BrayanACelisGodoy/ProyectoUcurrentUIS/5.Imagenes/Figura9 _2.JPG

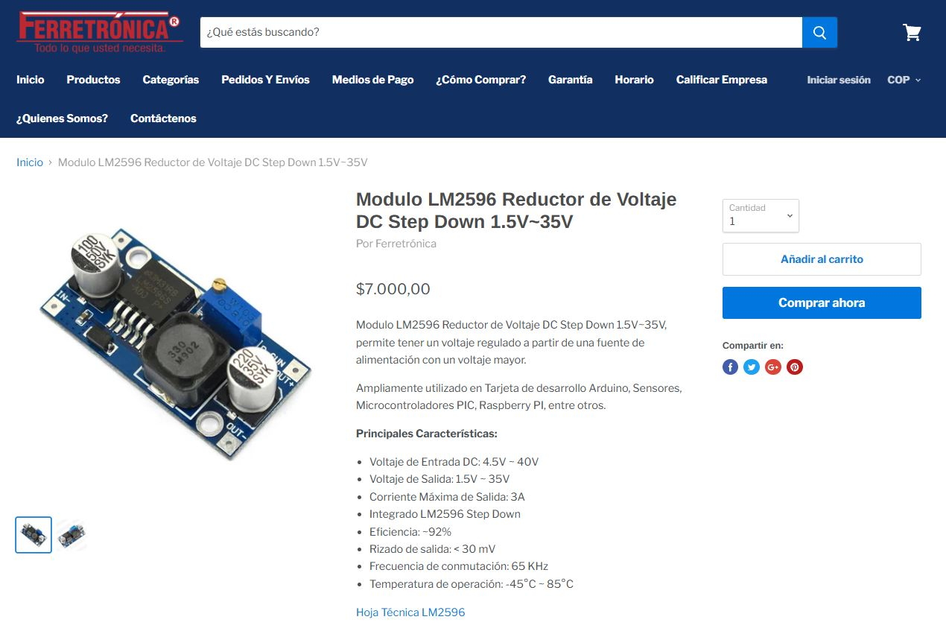
5.Imagenes/Figura9 _2.JPG
