BrayanACelisGodoy/ProyectoUcurrentUIS/5.Imagenes/Figura9 _1.JPG

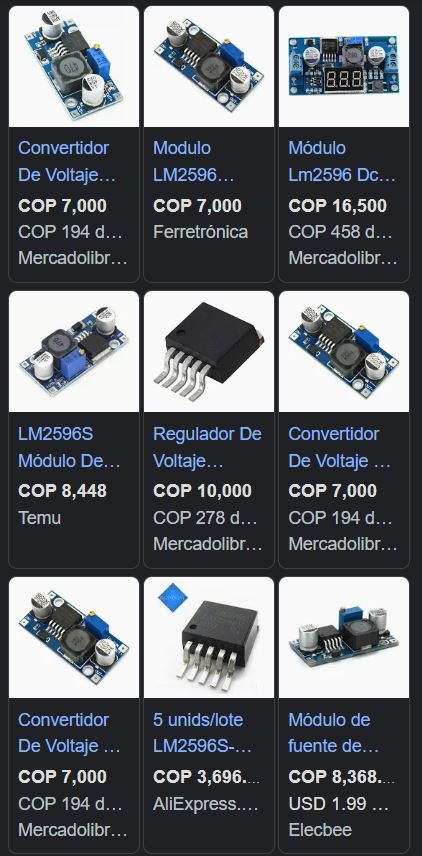
5.Imagenes/Figura9 _1.JPG
