BrayanACelisGodoy/ProyectoUcurrentUIS/4.Informe/Informe_uCurrent.odt

Proyecto Diseño y Mejoras μCurrent

Brayan Andres Celis Godoy, Jeiffer Bernal Tellez

Profesor

Jaime Guillermo Barrero Perez

Universidad Industrial de Santander

Facultad de Fisico-Mecanicas

Escuela de Eléctrica,Electrónica y Telecomunicaciones

Electrónica

Bucaramanga

2024

Tabla de Contenido

Pág.

Lista de Figuras

Pág.

Figura 1: Circuito medición de corriente a voltaje 11

Figura 2: Simulación ideal rango micro amperios 11

Figura 3: Simulación ideal rango mili amperios 11

Figura 4: Circuito comparador umbral mínimo y máximo 13

Figura 5: Circuito de resistencias de medición en rango automático 13

Figura 6: Circuito logica de encendido del mosfet 14

Figura 7: Circuito medición de corriente autónomo 15

Figura 8: Resultados de simulación 16

Lista de Apéndices

pág.

Apéndice A. Programa Esp-32 Visor online 20

(Se indican de dos formas: Si son menos de 27 apéndices, se listan con las letras del alfabeto, si son mayores de 27 apéndices, se listan con números. Al igual que las anteriores listas, también llevan el titulo completo)

Nota: Si los apéndices van dentro del cuerpo o contenido del trabajo de grado listados al final del mismo, se debe indicar el número de la página, si desea agruparlos en una carpeta adjunta no debe colocar número de página, en reemplazo, debe colocar un mensaje que indique:

“Los apéndices están adjuntos”

Glosario

Primer término: la definición inicia en minúscula

Segundo término: la definición inicia en minúscula

Tercer término: la definición inicia en minúscula

# Introducción

La medición de corriente en dispositivos microcontroladores es fundamental para evaluar su consumo y eficiencia, aspectos clave en el desarrollo de aplicaciones de bajo consumo energético. Es necesario contar con métodos efectivos y sencillos para monitorizar el consumo en dispositivos comerciales como el ATmega328P o el ESP32, que presentan múltiples niveles de consumo dependiendo del modo de operación en el que se encuentren. Estos niveles de corriente pueden variar desde mili amperios hasta micro amperios, especialmente en los modos de bajo consumo, como el modo de sueño profundo.

Dada la diversidad en los niveles de consumo de los microcontroladores, es crucial disponer de una herramienta que permita medir estos valores de corriente de manera manual o automática, cambiando entre diferentes rangos según sea necesario. Esto optimiza el monitoreo y asegura que los dispositivos operen de manera eficiente en todos sus estados de funcionamiento, desde el modo activo hasta los modos de ahorro de energía.

Este tipo de medición es particularmente importante en dispositivos que funcionan con baterías, donde el consumo de corriente afecta directamente la duración de la misma. Para maximizar el tiempo de funcionamiento de estos dispositivos, es esencial monitorizar el consumo sin introducir grandes pérdidas en el propio circuito de medición. Los sistemas de medición deben tener voltajes de fuga bajos y un impacto mínimo en el consumo global del dispositivo para que los resultados sean precisos y no comprometan la eficiencia energética general.

Además, en aplicaciones donde la batería es un recurso crítico, como en dispositivos portátiles o sistemas IoT, la capacidad de medir con precisión el consumo en diferentes modos operativos permite a los diseñadores optimizar tanto el hardware como el software, ajustando los ciclos de actividad y sueño profundo para extender la vida útil de la batería. De esta forma, el monitoreo preciso de la corriente no solo asegura un diseño eficiente, sino que también contribuye al desarrollo de dispositivos más duraderos y sostenibles.

# 1.Marco teórico

Los títulos de primer nivel se presentan centrados, con negrita. El párrafo inicia a dos espacios del titulo con una sangría de 1,27 cm al inicio del mismo. Estos títulos de primer nivel no necesariamente inician en hoja nueva, pueden iniciar por ejemplo a mitad de página o casi finalizando la hoja dejando dos espacios del párrafo anterior.

La separación entre párrafos es de una interlinea. Recordar que objetivos si se deben presentar en una hoja nueva.

# 2. Objetivos

## 2.1 Objetivo General

Desarrollar un sistema de medición de corriente para microcontroladores, que permita monitorizar el consumo de corriente en diferentes modos operativos, garantizando su precisión y eficiencia en el cambio automático entre rangos de corriente.

## 2.2 Objetivos Específicos

### 2.2.1 Desarrollo del sistema de medición mediante simulación

Diseñar y simular un sistema de medición de corriente que permita verificar el comportamiento del circuito de manera virtual antes de su implementación física.

### 2.2.2 Desarrollo del diseño del PCB

Desarrollar el esquema y diseño del PCB del sistema de medición de corriente, teniendo en cuenta los componentes seleccionados para garantizar un tamaño compacto, bajo consumo energético y bajo costo.

### 2.2.3 Desarrollo del sistema de visualización de lecturas

Desarrollar un aplicativo que permita la conexión y visualización inalámbrica de las lecturas de corriente del sistema, proporcionando una interfaz de usuario sencilla para el monitoreo en tiempo real.

# 3.Metodología

El diseño del circuito debe cumplir con características específicas que garanticen su correcto funcionamiento en microcontroladores. El sistema será operado por batería, lo que requiere un bajo consumo energético para maximizar la duración de la misma. El circuito estará orientado a la medición de corriente continua, y los rangos de medición serán de 500 mili amperios y 500 micro amperios.

La transición entre estos rangos deberá ser manual o automática, dependiendo de las necesidades operativas. Para garantizar una interferencia mínima en el sistema, el circuito deberá tener un voltaje de fuga de 5 mV/500 mA y 5 mV/500 µA, con una salida máxima de 500 mV en cualquier rango.

Finalmente, los datos de la medición deberán transmitirse inalámbrica mente a un dispositivo externo, como un celular o una computadora, para permitir el monitoreo remoto en tiempo real.

Todo esto se realizará mediante un desglose progresivo, partiendo de un modelo ideal del circuito hasta llegar a un desarrollo completo y detallado del sistema. Para validar el comportamiento del circuito, se realizarán simulaciones utilizando LTspice, lo que permitirá verificar el diseño antes de proceder a una posible implementación física.

## 3.1 Solución Ideal

El circuito de medición de corriente a voltaje es ampliamente utilizado en la industria y su construcción se basa en un amplificador operacional (opamp) configurado en retroalimentación negativa. En este tipo de configuración, el opamp actúa como un amplificador de transimpedancia, convirtiendo la corriente de entrada en un voltaje proporcional, lo que facilita la medición precisa de corrientes.

Para lograr una medición efectiva de corriente en microcontroladores, debemos tener en cuenta las resistencias de medición asociadas a los voltajes de fuga característicos del sistema. Los valores de estas resistencias se pueden calcular utilizando la relación entre el voltaje de fuga y la corriente máxima medida. De esta manera, obtenemos:

- {R} rsub {mA} = {5 mV} over {500 mA} = 10 left [m Ω right ]
- {R} rsub {μ A} = {5 mV} over {500 mA} = 10 left [Ω right ]

Con estos valores de resistencias, cumplimos las características de los voltajes de fuga exigidos por el sistema, asegurando una medición precisa sin introducir una carga significativa en el circuito.

Como se puede observar en la Figura 1, el circuito utiliza dos amplificadores operacionales conectados en cascada para mejorar el filtrado de la señal y optimizar la adquisición de datos. Los valores de amplificación de estos opamps se han ajustado para asegurar que el sistema sea capaz de aprovechar el rango completo de saturación Figura 1: Circuito medición de corriente a voltaje del amplificador, permitiendo una medición adecuada en los dos modos de operación (miliamperios y microamperios).

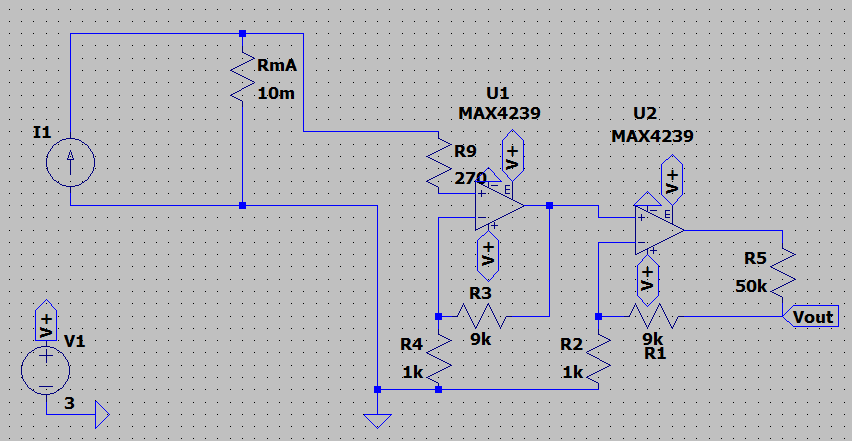
[picture p27: figure]
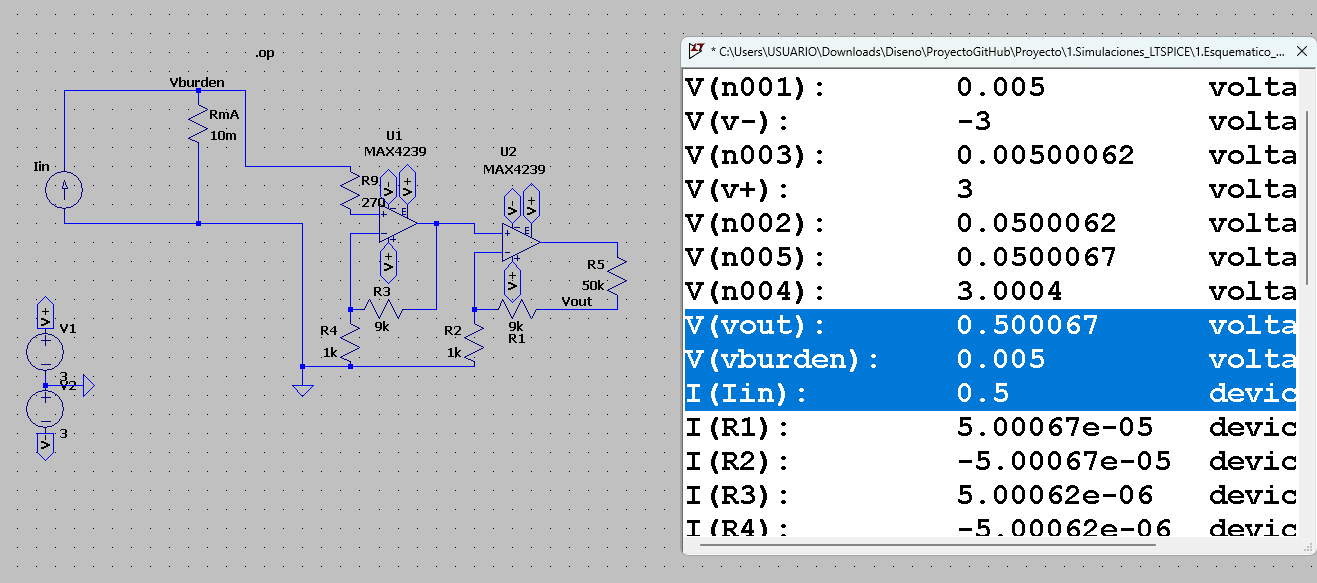
[picture p28: figure]

Medición mA

Figura 2: Circuito de medición en corriente de mA y µA

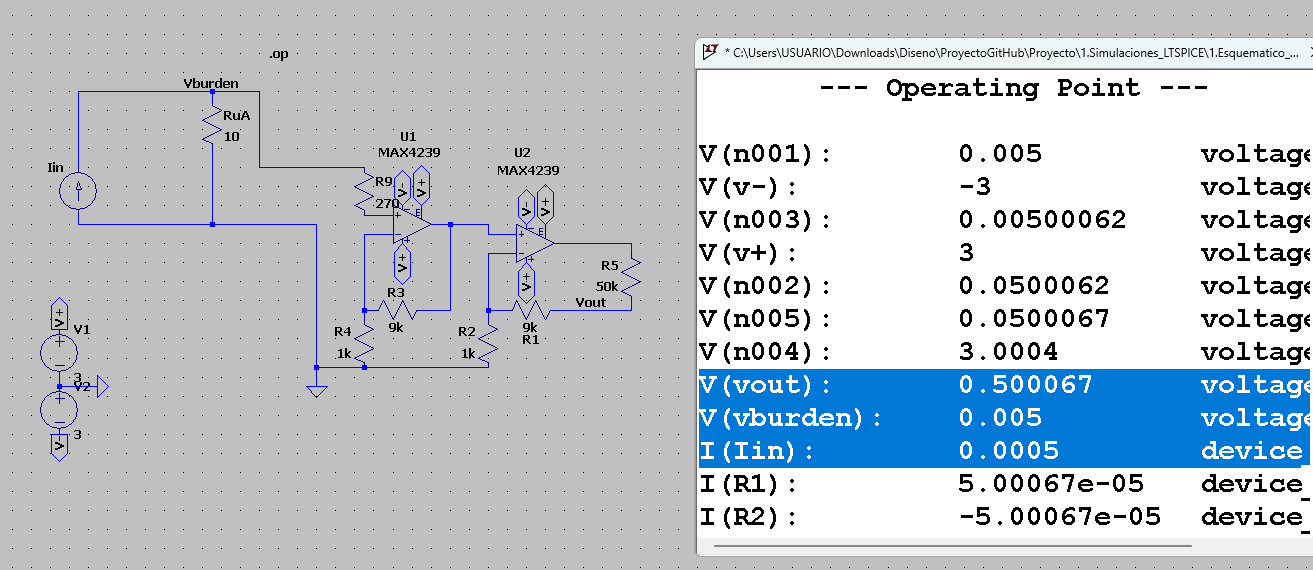
[picture p29: figure]

Medición µA

Como podemos observar en las Figura 2 la simulación ideal nos muestra que, con una corriente de 500 µA y 500 mA, se obtiene una salida de 500 mV, lo cual era el objetivo de diseño. Este resultado se alcanzó mediante la implementación de una amplificación con ganancia de 100 en el circuito, lo que permitió escalar las señales de corriente a niveles adecuados para su procesamiento.

Además, para ajustar el voltaje de salida dentro del rango deseado, se aplicó una división de voltaje. Este ajuste se logró mediante la colocación de una resistencia en serie a la salida del opamp, con un factor de división de 6, lo que permitió reducir el voltaje de salida al valor final de 500 mV en el punto de medición (Vout). De esta manera, conseguimos que el sistema entregue los 500 mV requeridos, tanto en el rango de 500 µA como en el de 500 mA, cumpliendo con las especificaciones del proyecto.

## 3.2 Solución por bloques

A partir de la solución ideal para la medición de corriente y su correspondiente rango de salida, se procede a desglosar el desarrollo de las demás características solicitadas, así como las mejoras que se desean implementar en el sistema. Estas mejoras se estructuran en bloques funcionales, cada uno de los cuales cumple una función específica dentro del sistema global.

### 3.2.1 Selector de Modo Automático

Para el modo de rango automático, se necesita un monitoreo constante de la salida. Cuando se supera un umbral de voltaje máximo, se debe cambiar del rango de µA a mA, y en el caso de caer por debajo del umbral de voltaje mínimo, se debe cambiar de mA a µA. Esto se puede lograr mediante el uso de amplificadores operacionales (opamps) configurados como comparadores de señal, encargados de detectar los límites y realizar el cambio de rango de manera automática.

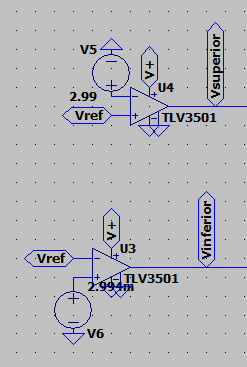
[picture p30: figure]

Figura 3: Circuito comparador umbral mínimo y máximo

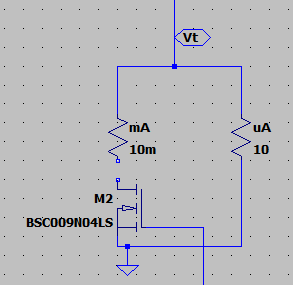
[picture p31: figure]

Figura 4: Circuito de resistencias de medición en rango automáticoComo se muestra en la Figura 3 el montaje de estos dos comparadores está diseñado para detectar los límites de cambio de rango. Cuando los comparadores detectan que se ha alcanzado el umbral predefinido, un MOSFET utilizado como switch actúa para cambiar el rango de medición. Este MOSFET permite una transición suave y eficiente entre los rangos de microamperios y miliamperios, ajustando la configuración del circuito en función de la corriente que se está midiendo.

En la Figura 4, se puede observar que el MOSFET se coloca en serie con la resistencia de 10 mΩ. Esto permite que el rango de medición de micro amperios permanezca activo utilizando la resistencia de 10 Ω, mientras que, al alcanzar el valor máximo de salida en este rango, el MOSFET se activa, realizando el cambio de rango automáticamente.

Físicamente, la corriente siempre tomará el camino de menor resistencia, por lo que, una vez que el MOSFET se encienda, la corriente pasará por la resistencia de 10 mΩ, permitiendo medir correctamente en el rango de mili amperios. Esto introduce una característica adicional importante en el circuito: la resistencia de encendido del MOSFET no debe ser muy alta, ya que podría alterar el valor de la medición en el rango de mA. Si la resistencia es demasiado elevada, afectaría la precisión de las mediciones al introducir una caída de tensión no deseada.

Dado que ya contamos con una señal lógica generada al superar los umbrales de voltaje definidos por los comparadores, es posible implementar un sistema lógico que controle el encendido del MOSFET de manera precisa. Este sistema lógico permitirá automatizar el cambio de rango entre microamperios y miliamperios, asegurando la independencia total del proceso de medición.

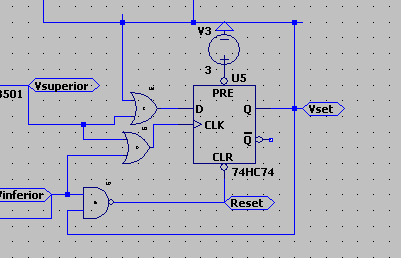
[picture p32: figure]

Figura 5: Circuito de lógica selección automática

En el circuito mostrado en la Figura 5, obtenemos la lógica de encendido utilizando un latch Set/Reset (SR). En la entrada D (Set), se encuentra una compuerta OR que recibe tanto la señal del umbral superior como la salida del propio latch. Esta configuración asegura que, una vez que la corriente supera el umbral superior, el latch se mantenga en el estado activado hasta que sea necesario cambiar de nuevo. La compuerta OR permite que la señal del umbral superior o el estado del latch puedan establecer el sistema, evitando que el cambio de estado ocurra accidentalmente debido a la medición.

Para gestionar los cambios entre rangos, utilizamos la entrada CLK del latch, que responde a flancos ascendentes. Las señales de los umbrales superior e inferior se combinan mediante otra compuerta OR, lo que genera el pulso de reloj necesario para realizar el cambio de rango. Así, el sistema puede cambiar automáticamente entre los rangos de micro amperios y mili amperios según el valor de la corriente medida.

El pin CLR (Reset), que tiene una lógica negada (se activa con un nivel bajo), está controlado por una compuerta NAND. Esta lógica garantiza que el sistema regrese al rango de µA cuando la corriente cae por debajo del umbral inferior y estaba previamente en el rango de mA. Esta combinación asegura que el sistema vuelva al modo de baja corriente solo cuando sea necesario, evitando cambios inesperados en el estado del latch.

En la Figura 6 se presenta el circuito completo de medición junto con el selector de rangos autónomos. Este circuito permite el cambio automático entre los rangos de mili amperios y micro amperios, de acuerdo con los umbrales predefinidos. Para observar el comportamiento del circuito en simulación, se utilizan dos fuentes de corriente: una que recorre los valores correspondientes al rango de mA y otra para los valores de µA Figura 6: Circuito medición de corriente autónomo.

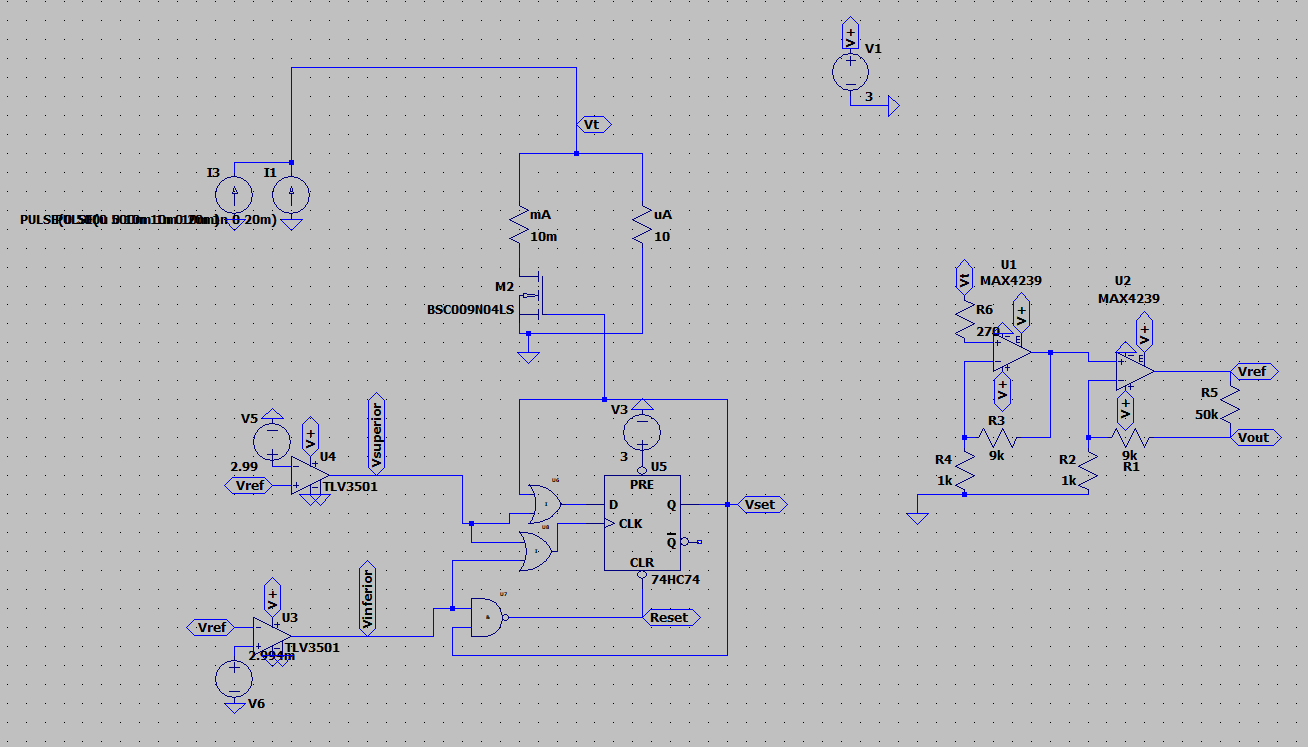
[picture p33: figure]

Al simular el circuito con estas dos fuentes, es posible visualizar las respuestas del sistema tanto en la señal de salida como en las corrientes que atraviesan las resistencias de medición. De esta manera, podemos verificar que el sistema cambia correctamente entre los rangos de medición de 10 mΩ para los mili amperios y 10 Ω para los micro amperios, dependiendo de los valores de corriente aplicados. Esto asegura que el selector de rangos autónomos funcione de manera eficiente y precisa en el control de la medición.

Como se puede observar en los resultados de simulación (Figura 7), los gráficos inferiores muestran el comportamiento del circuito cuando las dos fuentes de corriente alimentan el sistema. Las segunda y tercera gráficas representan las corrientes que atraviesan las resistencias de medición. En el momento en que la corriente alcanza valores de mili amperios, la resistencia asociada a este rango se activa automáticamente, aunque se puede notar una pequeña fuga a través de la resistencia del rango de micro amperios Figura 7: Resultados de simulación.

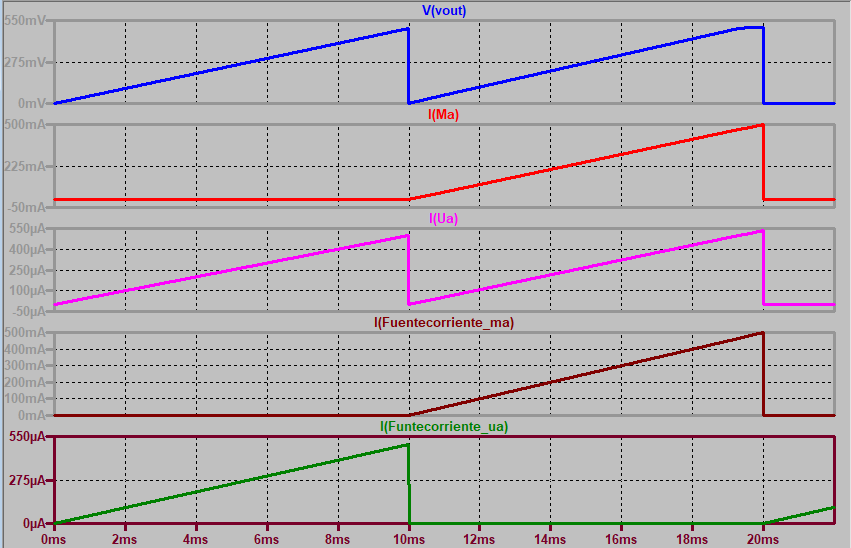
[picture p34: figure]

Finalmente, en la primera gráfica se muestra el voltaje de salida, que se mantiene en un rango cercano a 500 mV en ambos casos. Sin embargo, se observa que, debido a la resistencia asociada al MOSFET, el valor de salida en el rango de mili amperios se ve afectado, mostrando una pequeña desviación con respecto al valor ideal.

### 3.2.2 Módulo de Carga de Batería

Para maximizar el aprovechamiento de los recursos y garantizar un uso eficiente del circuito, se ha decidido utilizar una batería Li-Ion. La elección de este tipo de batería se debe a su alta densidad de energía y su capacidad de recarga, lo que evita el desperdicio de recursos al no tener que reemplazarla constantemente.

Para implementar el sistema de carga de la batería, existen dos enfoques posibles:

1. Compra de un módulo de carga completo: Este enfoque implica adquirir un módulo ya diseñado que cumpla con las características necesarias, como el tiempo de carga adecuado y los sistemas de seguridad integrados (protección contra sobrecarga, descarga profunda, etc.). Estos módulos suelen incluir un puerto de carga USB, lo que facilita su uso e integración.
2. Diseño propio del circuito de carga: Otra opción es diseñar y construir el sistema de carga utilizando componentes individuales, como el controlador de carga TP4056, que permite ajustar el proceso de carga de la batería según nuestras necesidades específicas. Aunque este enfoque ofrece mayor flexibilidad en el diseño, puede ser más laborioso y costoso en términos de tiempo.

En términos de selección, la opción más apropiada en muchos casos es comprar un módulo preensamblado, ya que suele ser más económico y ofrece la ventaja de estar completamente integrado, con todas las protecciones necesarias y un puerto de carga USB ya incluido.

(agregar imagenes del modulo y referencia del mismo y hablar de precio)

### 3.2.3 Módulo Conversor DC-DC

Otro elemento adicional que se podría incorporar al diseño es un conversor DC-DC, con el objetivo de alimentar el ESP32 y su módulo Wi-Fi, lo que permitiría el envío de datos de manera inalámbrica. Este conversor también serviría para mantener un valor de alimentación fijo de 3V para el circuito, dado que fue bajo este voltaje que se realizó la calibración de todo el sistema.

Al igual que el módulo de carga, el conversor DC-DC puede ser adquirido como un módulo pre ensamblado, que ya cumpla con las características necesarias para ofrecer estabilidad en la salida. Alternativamente, se podría diseñar e implementar utilizando componentes discretos, como el LM2596, que permitiría ajustar el voltaje de salida y garantizar la estabilidad del sistema.

La elección entre comprar un módulo pre ensamblado o realizar el diseño propio dependerá de factores como el costo y el tiempo. En muchos casos, adquirir un módulo pre ensamblado es la opción más práctica, ya que asegura la estabilidad del voltaje y minimiza el riesgo de comprometer la calibración del sistema o la integridad del microcontrolador que se utiliza para el envío de datos.

# 4. Desarrollo del PCB

## 4.1 Esquemáticos PCB

# 5. Desarrollo de aplicación

Dadas las especificaciones requeridas para el circuito, donde la única función obligatoria del ESP32 es enviar los datos a una interfaz gráfica para su visualización en un computador o dispositivo móvil, al utilizar herramientas como el ESP32 para la lectura de estos datos análogos tenemos que tener en cuenta la incertidumbre que se genera al tener una conexión de esta señal análoga y ser convertida a bits mas exactamente los 12 bits de la esp32 podemos calcular la incertidumbre siendo que conocemos el rango máximo de salida que es de 500 mV.

incertidumbre=frac{ 2^{bits} }{ rango Max }=frac{ 2^12 }{ 500mV }=0,122mV

Con este resultado podemos obtener que en la visualización que realicemos sin importar como se haga tendremos este valor de ± 0,122mV en la medición,con lo cual ya nos quedar desarrollar como queremos que sea la lectura de los dato,existen dos posibles enfoques para el desarrollo de la aplicación:

1. Servidor web con el ESP32: Se decidió optar por esta opción debido a la autonomía del circuito, ya que el ESP32 solo funcionará como un mediador entre el circuito de medición y el dispositivo de visualización. En este caso, se desarrollará un servidor web utilizando el ESP32, permitiendo que cualquier dispositivo conectado a su red visualice los datos a través de un navegador. La página web se desarrollará en HTML, lo que permitirá que los datos sean accesibles desde cualquier dispositivo con un navegador, siempre y cuando esté conectado a la red generada por el ESP32. Esta opción es práctica y versátil, permitiendo el acceso sin necesidad de instalar software adicional.
2. Aplicativo dedicado (aparte): Aunque se ha optado por el servidor web, se incluirá un apartado que explorará la posibilidad de desarrollar un aplicativo dedicado. Este enfoque podría cambiar el procesamiento de la señal, controlando completamente el sistema a través del microcontrolador ESP32. Un aplicativo dedicado podría ser desarrollado tanto para computador como para celular, ofreciendo mayor control sobre el sistema y permitiendo optimizar la experiencia de usuario. Sin embargo, tendría la desventaja de requerir versiones diferentes para cada tipo de dispositivo y la necesidad de que los usuarios instalen la aplicación.

Cada enfoque tiene sus ventajas y desventajas. El servidor web es más versátil y fácil de implementar, mientras que un aplicativo dedicado ofrecería mayor control y personalización, con la posibilidad de cambiar la forma en que se procesa y controla la señal directamente desde el ESP32.

## 5.1 Aplicativo mediante servidor web

Dado que el diseño del circuito es completamente autónomo en el procesamiento de la señal, y la ESP32 solo se utilizará para enviar la información a un celular o computador, el desarrollo del aplicativo de visualización se enfocará únicamente en mostrar el valor medido. Con el circuito del latch manejando la lógica de cambio de rangos, la ESP32 solo necesitará implementar un sistema que permita visualizar los datos a través de un navegador web.

El desarrollo del aplicativo en el servidor web incluirá:

- Un puerto de entrada de la ESP32 para la visualización del valor medido (corriente).
- Un puerto de detección que indicará si el sistema está operando en el rango de miliamperios (mA) o microamperios (µA).
- Un puerto para el modo automático, que indicará si el sistema está realizando los cambios de rango automáticamente.

Otra manera posible de realizar la visualización de los datos es conectando la ESP32 a una red Wi-Fi existente. Conociendo su dirección IP, los usuarios podrán acceder a la interfaz web y visualizar los datos desde cualquier dispositivo en la misma red. Esta opción permite una mayor flexibilidad en la conexión y acceso remoto a los datos sin depender de una red generada exclusivamente por el ESP32.

Este diseño web permitirá a los usuarios visualizar en tiempo real el estado y las mediciones del sistema a través de cualquier dispositivo conectado a la red del ESP32, ya sea mediante su propia red o una red Wi-Fi existente.

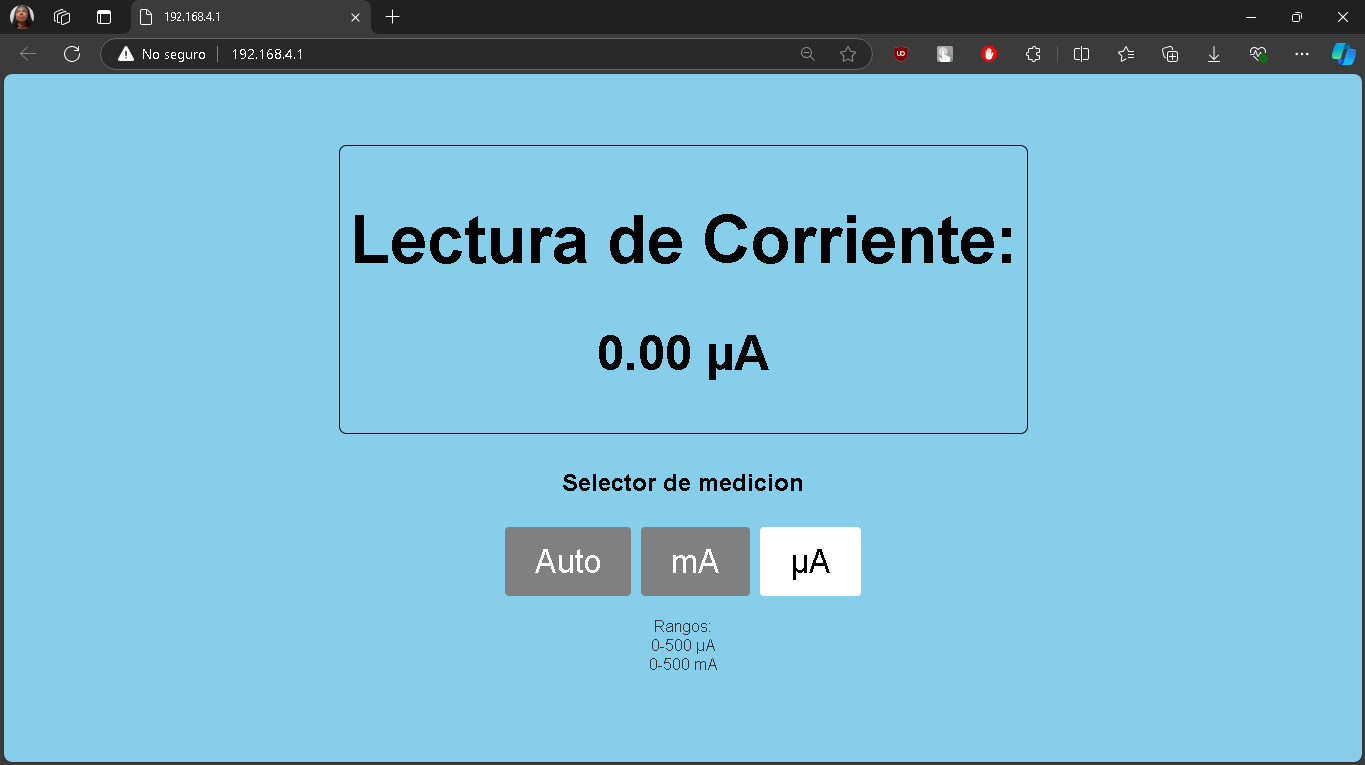
[picture p35: figure]
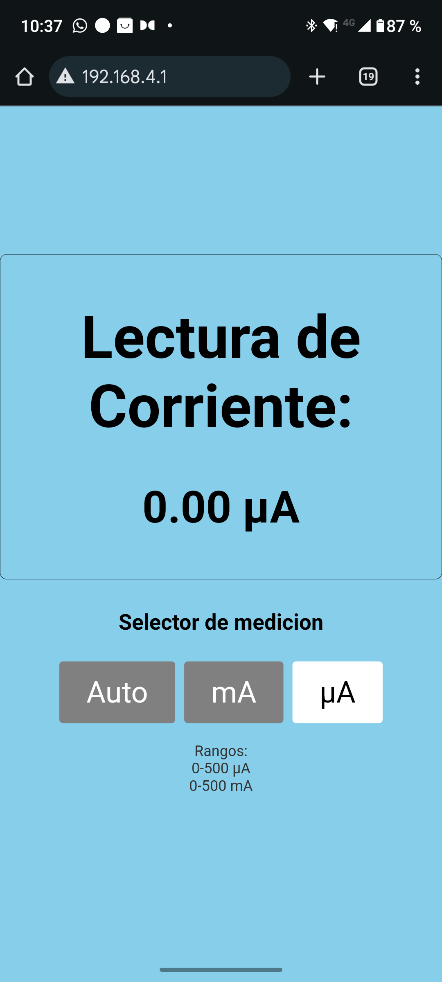
[picture p36: figure]

Visualizado en PC Visualizado en Celular

Figura 8: Esquema visualización por HTML

En la Figura 8 se puede ver el desarrollo de la página web, tanto en un PC como en un celular, mostrando la interfaz diseñada para la visualización de los datos. En el apéndice A se incluye el código fuente utilizado para el desarrollo del servidor web, acompañado de una explicación detallada de su funcionamiento. En este caso, se ha configurado el ESP32 para que genere una red Wi-Fi propia, a la cual se conecten los dispositivos que visualizarán los datos.

## 5.2 Aplicativo dedicado

Dado un enfoque con un aplicativo dedicado la mejor opcion seria eliminar la parte logica del circuito con lo cual en ves de depender de la lógica del latch para los cambios de rango se haria un procesamiento de la señal en el esp32 el cual se encargaría de controlar el mosfet.

El desarrollo de un aplicativo dedicado incluira:

- Un puerto de entrada de la ESP32 para la visualización del valor medido (corriente).
- Un puerto de activación que sera el encargado de controlar el encendido del mosfet en los diferentes rangos.
  El uso de aplicación dedicada nos permite eliminar el procesado por HTML en el propio esp32 lo cual puede significar una mejora de eficiencia ya que se puede colocar en el modo de sueño ligero todo el tiempo y despertarse para procesar y enviar los datos solo cuando detecte cambio.

# 6. Conclusiones

(Va en capitulo separado de las conclusiones, pero no necesariamente en hoja nueva y en este apartado se expresa las perspectivas del autor a fin de complementar con nuevas ideas a la investigación original)

# Referencias Bibliográficas

(No lleva número de capitulo e inicia en hoja nueva)

Ejemplo

Congreso de la República de Colombia (1979). Ley 11 del 5 de marzo de 1979 “Por la cual se reconoce la profesión de bibliotecólogo y se reglamenta su ejercicio”. Bogotá: El Congreso

Todas las referencias de las citas del trabajo de grado deben aparecer en esta lista, al igual que las fuentes consultadas. Deben ir en orden alfabético y la primera línea de cada referencia debe ir contra el margen izquierdo, si tiene una segunda o más líneas, lleva sangría después de la primera línea [sangría francesa].

# Apéndices

(No lleva número de capitulo e inicia en hoja nueva)

## Apéndice A. Programa Esp-32 Visor online

#include <WiFi.h>

#include <WebServer.h>

const char* ssid = "ESP32_AP";

const char* password = "123456789";

// Crear una instancia del servidor web

WebServer server(80);

// Definir los pines de entrada

const int pinAutoInput = 19; // Pin para la entrada Auto (GPIO19)

const int pinRangeInput = 5; // Pin para la entrada de rango (uA/mA) (GPIO5)

const int inputPin = 34; // Pin 34 como entrada de señal analógica

// Función para leer la corriente sin conversión

float readCurrent() {

int sensorValue = analogRead(inputPin);

float voltage = (sensorValue / 4095.0) * 3300.0; // Convertir a milivoltios (0-3300mV)

return voltage;

}

// Función para la página principal

void handleRoot() {

// Leer los estados lógicos de las entradas

bool isAuto = digitalRead(pinAutoInput);

bool isMilliAmp = digitalRead(pinRangeInput); // HIGH = mA, LOW = uA

// Definir la unidad de medida dependiendo del estado del pin de rango

String displayUnit = "";

if (isAuto) {

displayUnit = "Auto";

} else if (isMilliAmp) {

displayUnit = "mA";

} else {

displayUnit = "µA";

}

float currentValue = readCurrent(); // Leer la corriente

// Crear el contenido HTML

String html = "<html><head>";

html += "<meta charset='UTF-8'>"; // Añadir la codificación UTF-8

html += "<style>";

html += "html, body { height: 100%; margin: 0; font-family: Arial; font-size: 1.6em; background-color: #87CEEB; }"; // Fondo celeste

html += "body { display: flex; justify-content: center; align-items: center; }";

html += ".container { text-align: center; }";

html += ".box { border: 1px solid black; display: inline-block; padding: 20px; margin-bottom: 20px; border-radius: 15px; font-size: 1.6em; }";

html += ".button { padding: 30px 60px; font-size: 1.6em; margin: 10px; background-color: grey; color: white; border: none; cursor: pointer; border-radius: 8px; }";

html += ".button.selected { background-color: white; color: black; }"; // Botón seleccionado en blanco

html += ".small-text { font-size: 0.8em; color: #333; }";

html += "</style>";

// Añadir JavaScript para auto-actualización

html += "<script>";

html += "setInterval(function() { window.location.reload(); }, 1000);"; // Refrescar cada 1 segundo

html += "</script>";

html += "</head><body>";

html += "<div class='container'>";

html += "<div class='box'><h1>Lectura de Corriente:</h1>";

html += "<h2>" + String(currentValue, 2) + " " + displayUnit + "</h2></div>";

html += "<h3>Selector de medicion</h3>";

// Botones con estado visual según las entradas

html += "<input class='button " + String((isAuto) ? "selected" : "") + "' type='button' value='Auto'>";

html += "<input class='button " + String((!isAuto && isMilliAmp) ? "selected" : "") + "' type='button' value='mA'>";

html += "<input class='button " + String((!isAuto && !isMilliAmp) ? "selected" : "") + "' type='button' value='µA'>";

html += "<p class='small-text'>Rangos:<br>0-500 µA<br>0-500 mA</p>";

html += "</div>";

html += "</body></html>";

server.send(200, "text/html", html);

}

void setup() {

Serial.begin(115200);

pinMode(inputPin, INPUT);

pinMode(pinAutoInput, INPUT);

pinMode(pinRangeInput, INPUT);

WiFi.softAP(ssid, password);

Serial.println("Punto de acceso iniciado");

Serial.print("IP del ESP32: ");

Serial.println(WiFi.softAPIP());

server.on("/", handleRoot);

server.begin();

}

void loop() {

server.handleClient();

if (WiFi.status() == WL_CONNECTED) {

esp_sleep_enable_timer_wakeup(5000000); // Configurar para despertar cada 5 segundos

esp_light_sleep_start(); // Entrar en light sleep

}

}

## Apéndice B.Programa ESP-32 aplicación dedicada.

#include <WiFi.h>

#include <WebServer.h>

const char* ssid = "ESP32_AP";

const char* password = "123456789";

// Crear una instancia del servidor web

WebServer server(80);

// Definir el pin de salida para el MOSFET

const int mosfetPin = 18; // Pin para controlar el MOSFET (GPIO18)

// Variables para guardar el estado del sistema

String mode = "uA"; // Modo actual (uA, mA, Auto)

float currentValue = 0.0; // Valor de corriente leído

String range = "µA"; // Escala de medición actual (uA o mA)

// Función para leer la corriente sin conversión

float readCurrent() {

int sensorValue = analogRead(34); // Pin 34 como entrada de señal analógica

float voltage = (sensorValue / 4095.0) * 500.0; // Convertir a milivoltios (0-3300mV)

return voltage;

}

// Función para procesar el modo automático

void handleAutoMode(float currentValue) {

if (currentValue >= 495) {

// Activar el MOSFET cuando la corriente supere los 495mV

digitalWrite(mosfetPin, HIGH);

range = "mA"; // Cambiar la escala a miliamperios cuando el MOSFET esté encendido

} else if (currentValue < 1) {

// Apagar el MOSFET cuando la corriente sea inferior a 1mV

digitalWrite(mosfetPin, LOW);

range = "µA"; // Cambiar la escala a microamperios cuando el MOSFET esté apagado

}

}

// Función para manejar el cambio de modo desde la aplicación

void handleSetMode() {

if (server.hasArg("mode")) {

mode = server.arg("mode");

// Lógica para los modos

if (mode == "mA") {

digitalWrite(mosfetPin, HIGH); // Encender MOSFET en mA

range = "mA"; // Fijar el rango en miliamperios

} else if (mode == "uA") {

digitalWrite(mosfetPin, LOW); // Apagar MOSFET en uA

range = "µA"; // Fijar el rango en microamperios

}

// No encendemos/apagamos directamente en modo Auto, lo hace handleAutoMode()

}

// Responder a la aplicación confirmando el cambio de modo

server.send(200, "text/plain", "Mode changed to " + mode);

}

// Función para devolver los datos actuales en formato JSON

void handleData() {

currentValue = readCurrent(); // Leer la corriente

// Si el modo es "Auto", procesar automáticamente y cambiar la escala

if (mode == "Auto") {

handleAutoMode(currentValue);

}

// Crear el JSON con las variables que queremos enviar

String jsonData = "{";

jsonData += "\"current\": " + String(currentValue, 2) + ","; // Agregar lectura de corriente

jsonData += "\"mode\": \"" + mode + "\","; // Enviar el modo actual

jsonData += "\"range\": \"" + range + "\""; // Enviar la escala actual (mA o µA)

jsonData += "}";

// Enviar los datos en formato JSON

server.send(200, "application/json", jsonData);

void enterLightSleep() {

Serial.println("Entrando en Light Sleep...");

// Configurar el tiempo de sueño (por ejemplo, 10 segundos)

esp_sleep_enable_timer_wakeup(10 * 1000000); // 10 segundos en microsegundos

Serial.flush(); // Limpiar el buffer serial

esp_light_sleep_start(); // Entrar en light sleep

wakeup_count++; // Contador de veces que ha despertado

Serial.println("Despertado del Light Sleep");

}

enterLightSleep();

}

void setup() {

Serial.begin(115200);

// Configurar los pines

pinMode(34, INPUT); // Pin 34 para la señal de corriente

pinMode(mosfetPin, OUTPUT); // Pin para el MOSFET

// Configurar el WiFi

WiFi.softAP(ssid, password);

Serial.println("Punto de acceso iniciado");

Serial.print("IP del ESP32: ");

Serial.println(WiFi.softAPIP());

// Configurar las rutas del servidor

server.on("/setMode", handleSetMode); // Endpoint para cambiar el modo

server.on("/data", handleData); // Endpoint para obtener los datos actuales

server.begin(); // Iniciar el servidor

}

void loop() {

server.handleClient(); // Manejar las solicitudes del cliente

}

(Los apéndices se indican de dos formas: Si son menos de 27 apéndices, se listan con las letras del alfabeto, si son mayor o igual a 27 apéndices, se listan con números arábigos. Al igual que las anteriores listas, también llevan el título completo)

Nota: Si los apéndices van dentro del cuerpo o contenido del trabajo de grado listados al final del mismo, se debe indicar el número de la página, si desea agruparlos en una carpeta adjunta no debe colocar número de página, en reemplazo, debe colocar un mensaje que indique:

“Los apéndices están adjuntos y puede visualizarlos en la base de datos de la biblioteca UIS”

Tener en cuenta que, en el uso de Normas APA no pueden ir contenidos en mayúscula (Incluyendo títulos), Sólo en mayúsculas las siglas y la cornisa.

Las recomendaciones y sugerencias para la elaboración de esta plantilla fueron obtenidas y adaptadas teniendo en cuenta la Guía resumen del Manual de Publicaciones con Normas APA

Séptima edición 2020 | www.normasapa.pro Traducción basada en: https://apastyle.apa.org/style-grammar-guidelines/index y en American Psychological Association (2020)

UNIVERSIDAD INDUSTRIAL DE SANTANDER 29
