BrayanACelisGodoy/ProyectoUcurrentUIS/5.Imagenes/Figura1.png

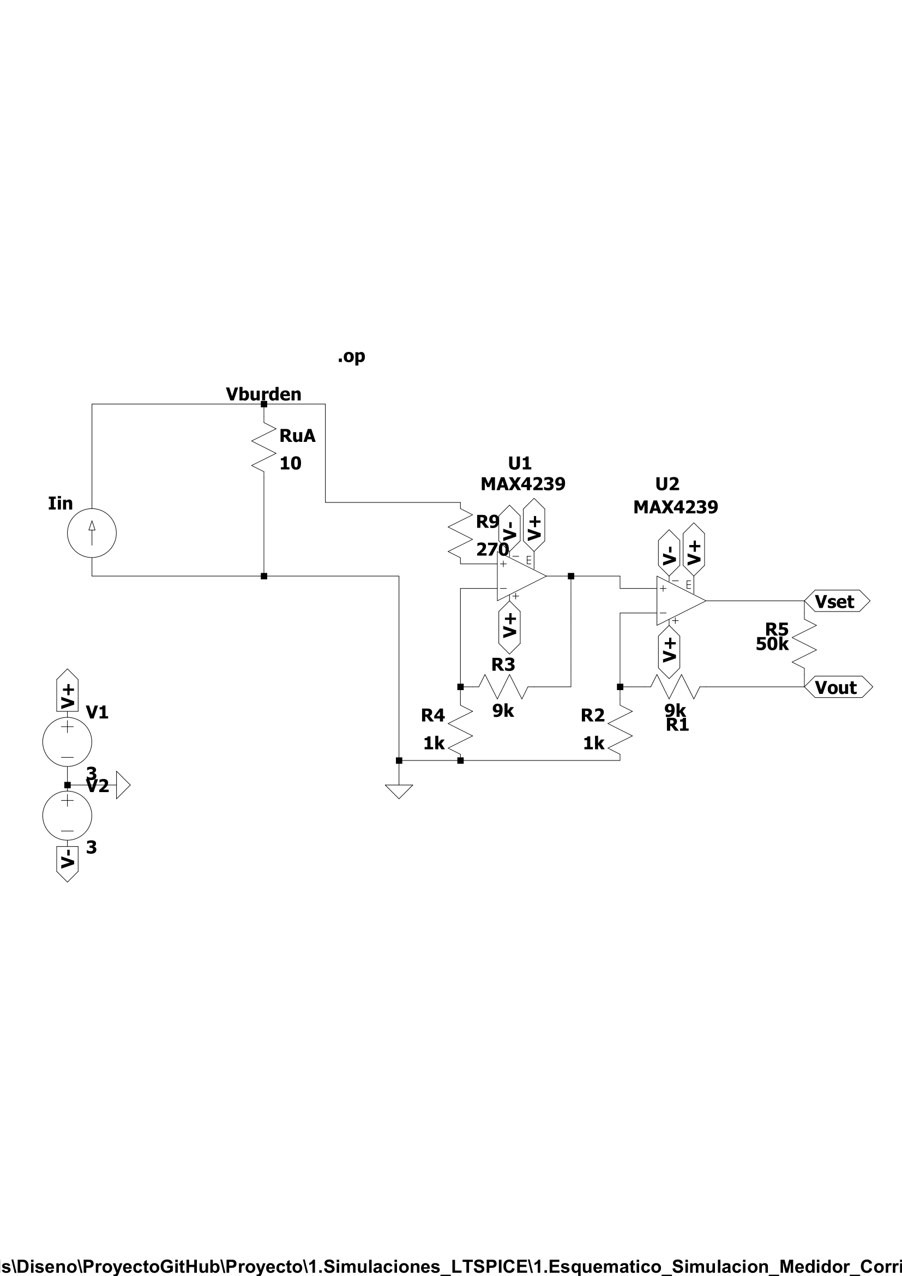
5.Imagenes/Figura1.png
