BrayanACelisGodoy/ProyectoUcurrentUIS/5.Imagenes/Figura2_1.png

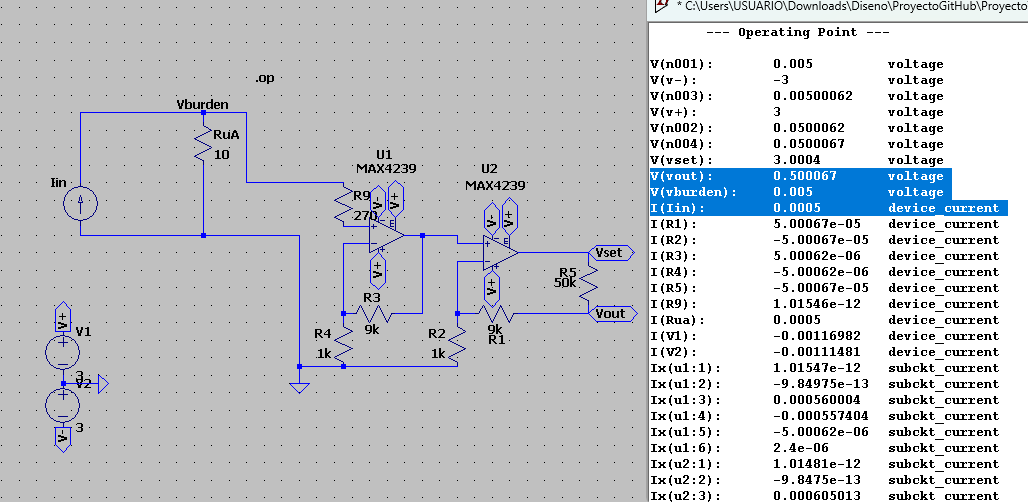
5.Imagenes/Figura2_1.png
