BrayanACelisGodoy/ProyectoUcurrentUIS/5.Imagenes/Figura2_2.png

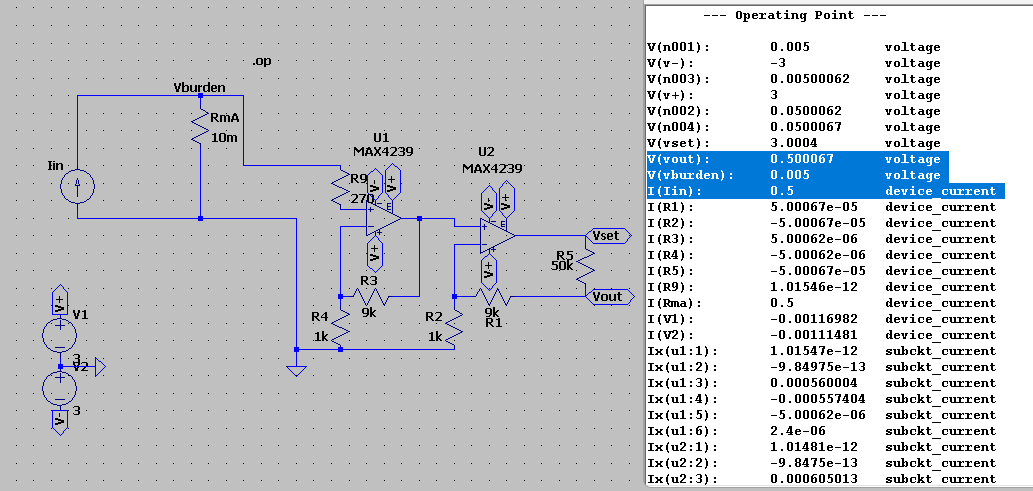
5.Imagenes/Figura2_2.png
