BrayanACelisGodoy/ProyectoUcurrentUIS/5.Imagenes/Figura6.png

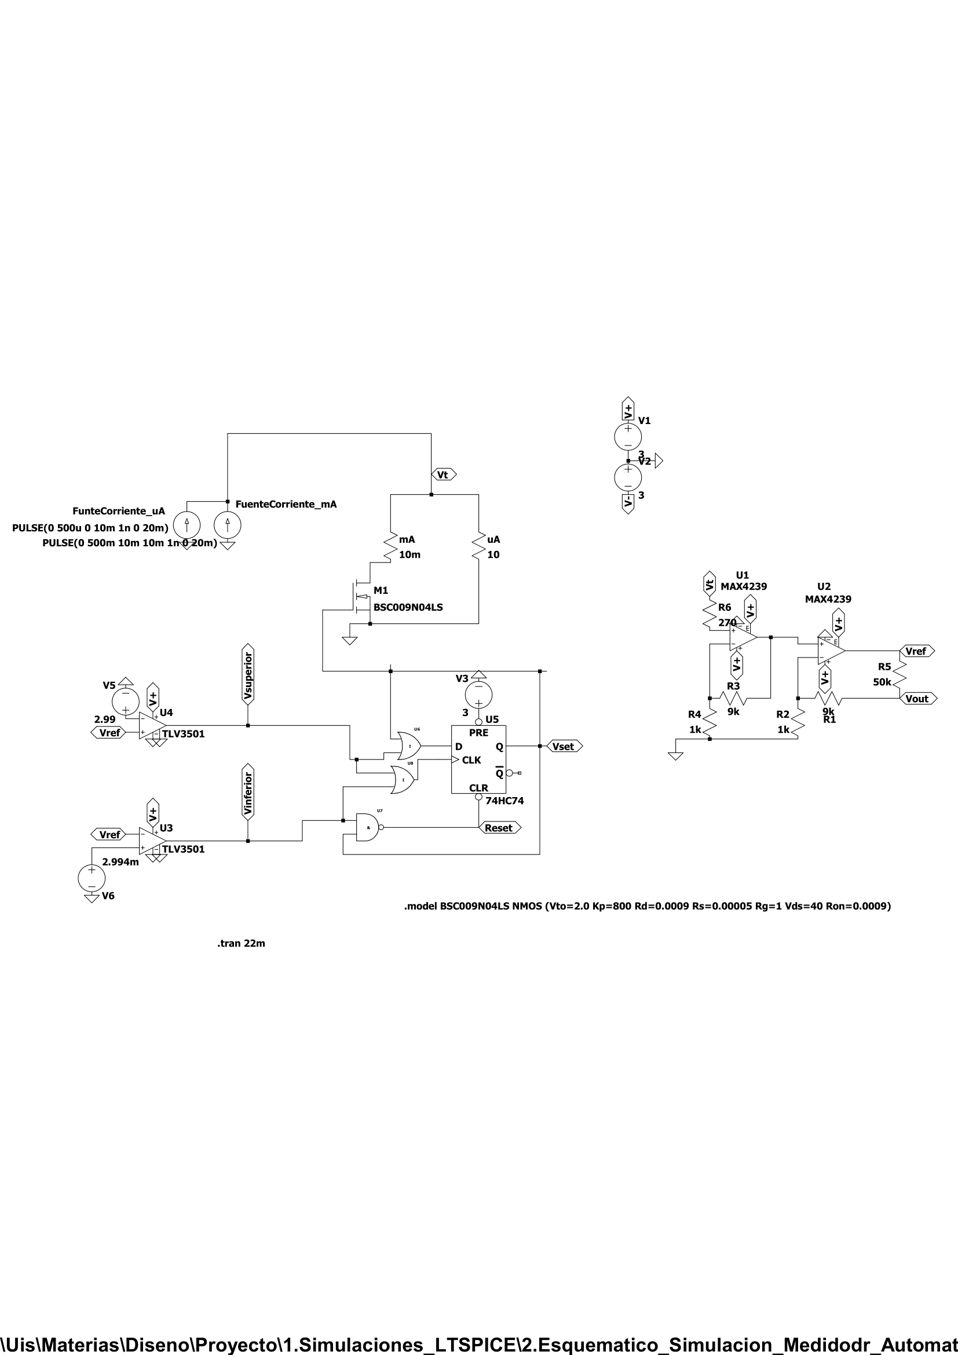
5.Imagenes/Figura6.png
