BrayanACelisGodoy/ProyectoUcurrentUIS/5.Imagenes/Figura7.png

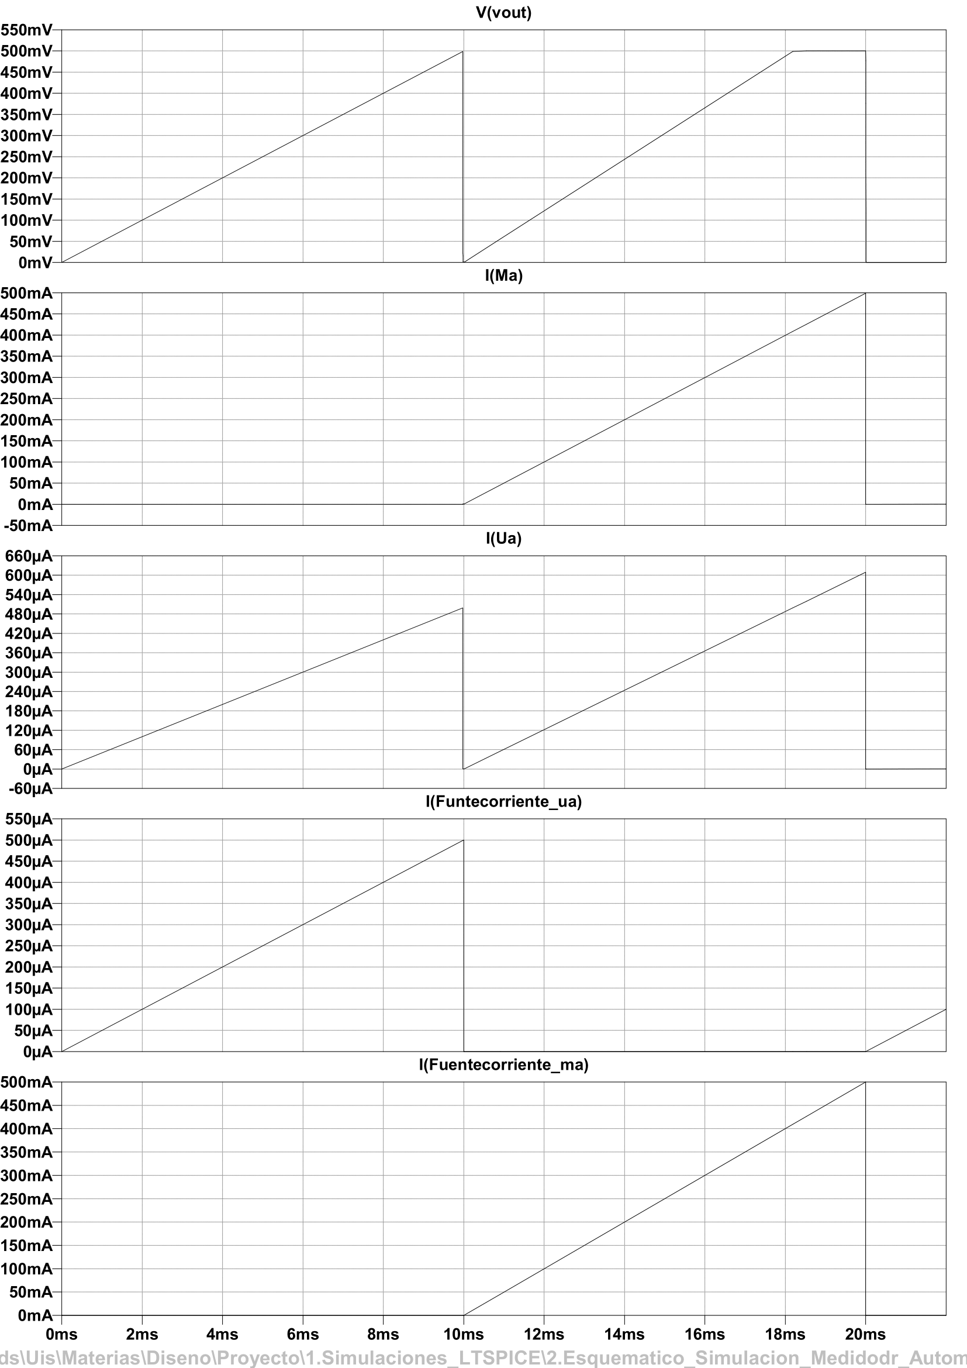
5.Imagenes/Figura7.png
