BrayanACelisGodoy/ProyectoUcurrentUIS/5.Imagenes/Figura8_1.JPG

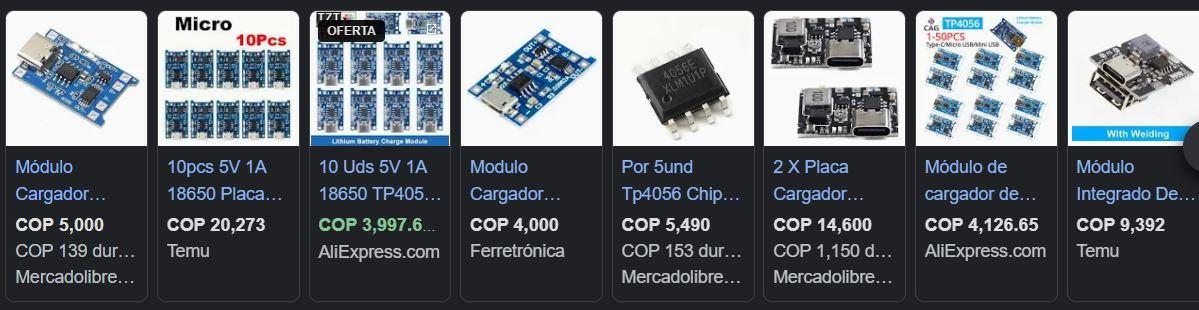
5.Imagenes/Figura8_1.JPG
