BrayanACelisGodoy/ProyectoUcurrentUIS/5.Imagenes/Figura8_2.JPG

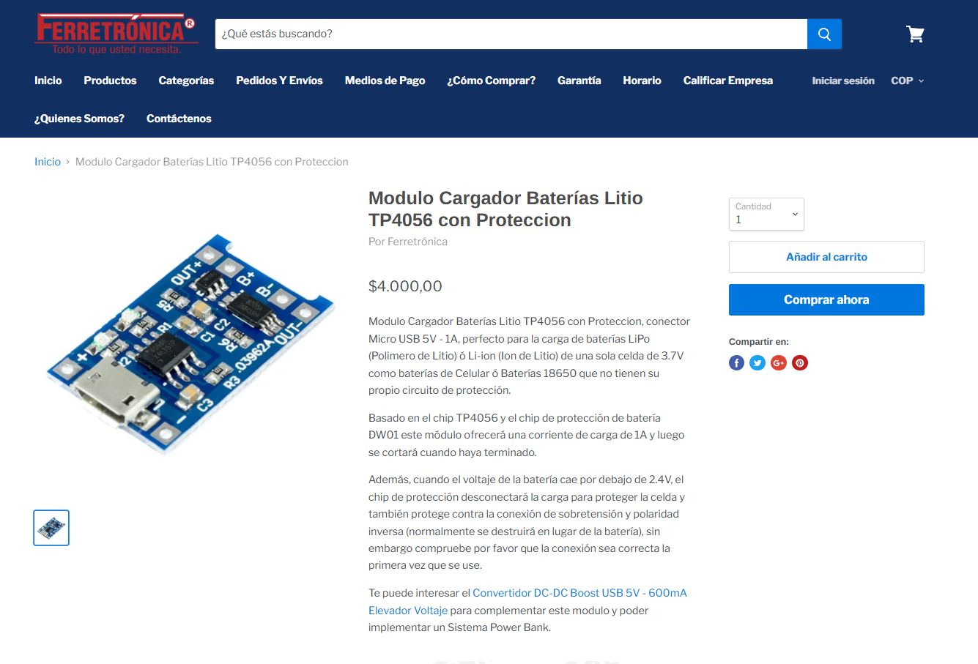
5.Imagenes/Figura8_2.JPG
