BrayanACelisGodoy/ProyectoUcurrentUIS/5.Imagenes/Figura10.png

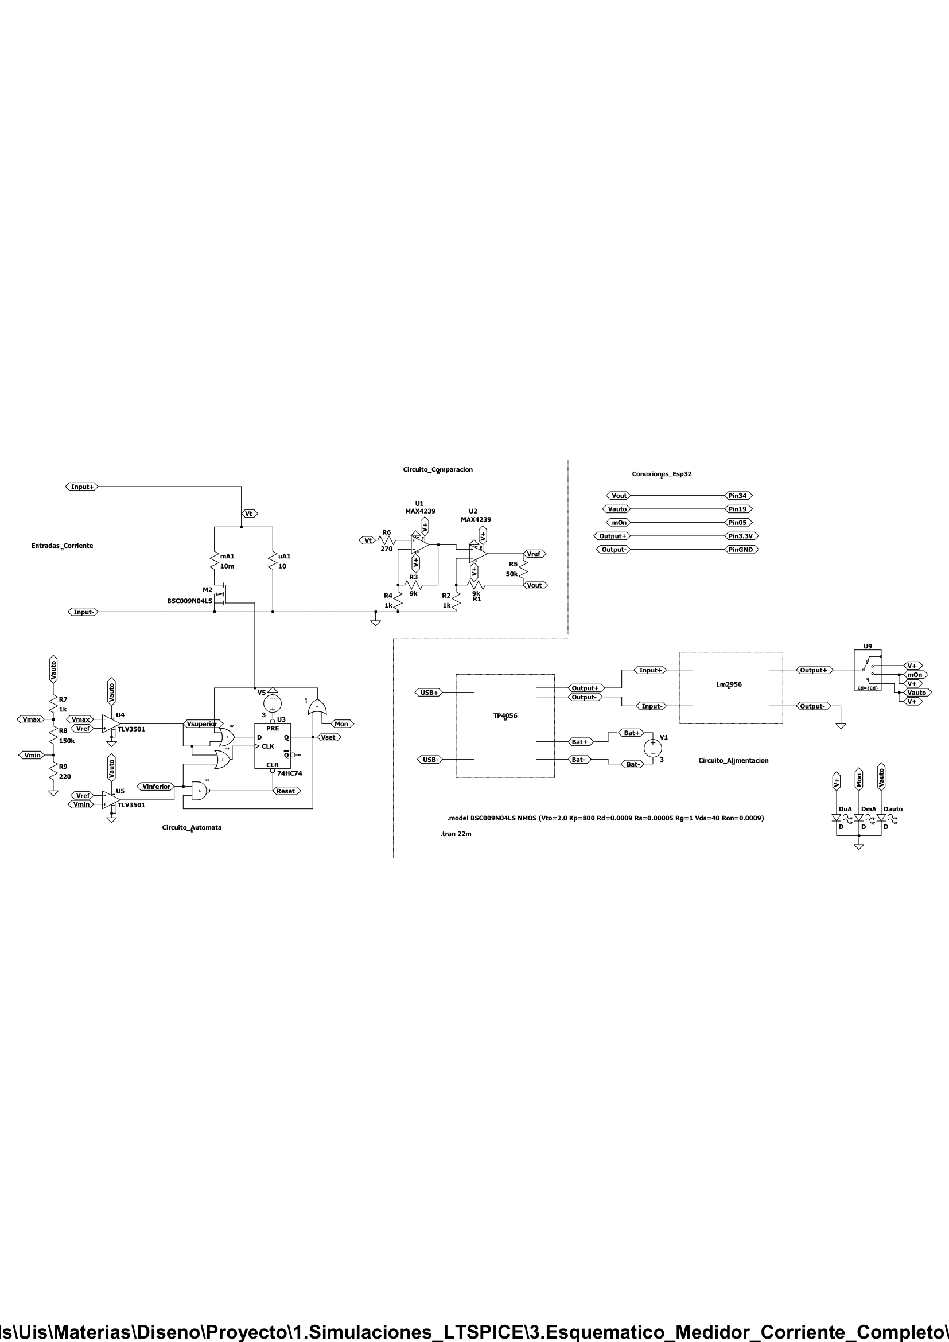
5.Imagenes/Figura10.png
