BrayanACelisGodoy/ProyectoUcurrentUIS/5.Imagenes/figura14.png

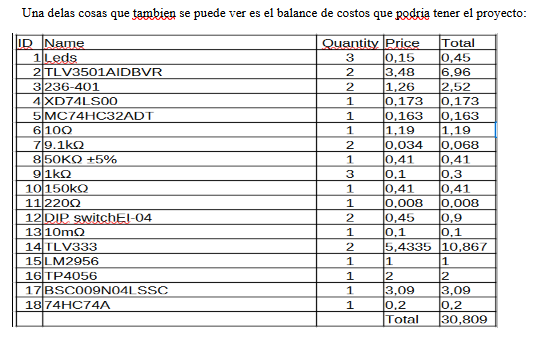
5.Imagenes/figura14.png
