BrayanACelisGodoy/ProyectoUcurrentUIS/3.PCB_EasyEDA/BOM_uCurrent_2024-10-15.csv

ID | Name | Quantity | Price | Total
1 | Leds | 3 | 0,15 | 0,45
2 | TLV3501AIDBVR | 2 | 3,48 | 6,96
3 | 236-401 | 2 | 1,26 | 2,52
4 | XD74LS00 | 1 | 0,173 | 0,173
5 | MC74HC32ADT | 1 | 0,163 | 0,163
6 | 10Ω | 1 | 1,19 | 1,19
7 | 9.1kΩ | 2 | 0,034 | 0,068
8 | 50KΩ ±5% | 1 | 0,41 | 0,41
9 | 1kΩ | 3 | 0,1 | 0,3
10 | 150kΩ | 1 | 0,41 | 0,41
11 | 220Ω | 1 | 0,008 | 0,008
12 | DIP switchEI-04 | 2 | 0,45 | 0,9
13 | 10mΩ | 1 | 0,1 | 0,1
14 | TLV333 | 2 | 5,4335 | 10,867
15 | LM2956 | 1 | 1 | 1
16 | TP4056 | 1 | 2 | 2
17 | BSC009N04LSSC | 1 | 3,09 | 3,09
18 | 74HC74A | 1 | 0,2 | 0,2
 |  |  | Total | 30,809
 | https://www.digikey.com/short/qqwfvwtq
