BrayanACelisGodoy/ProyectoUcurrentUIS/3.PCB_EasyEDA/BlancoYNegro/BottomLayer.pdf

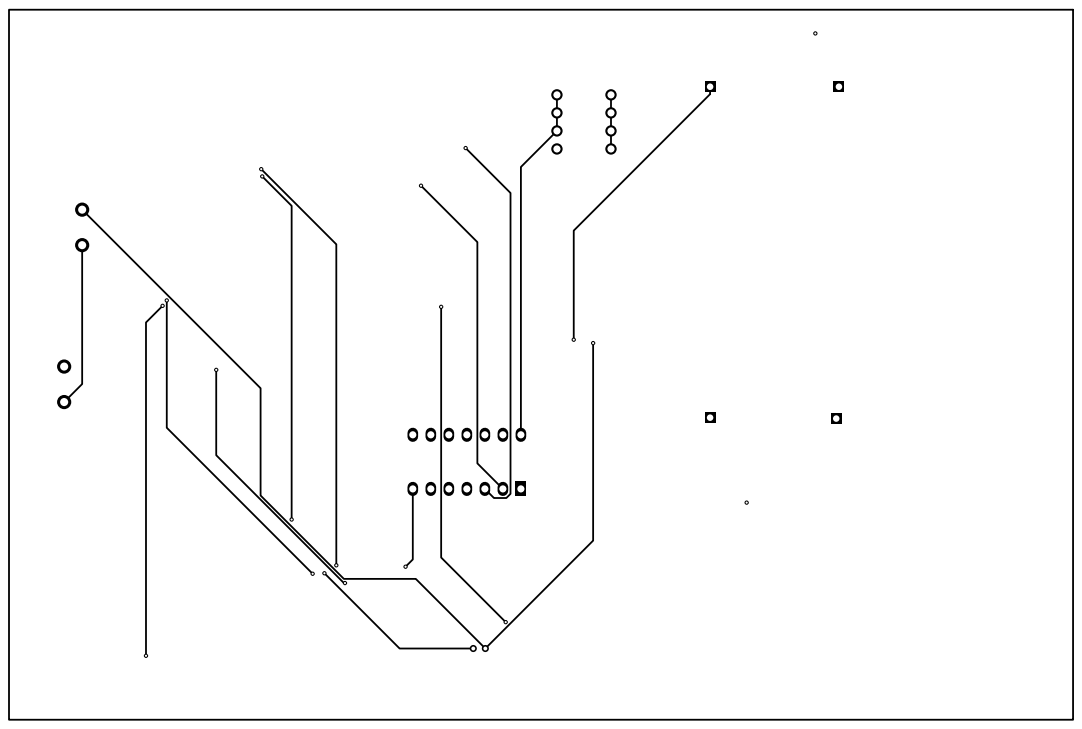
[picture p76: page 1]
