BrayanACelisGodoy/ProyectoUcurrentUIS/3.PCB_EasyEDA/BlancoYNegro/Multi-Layer.pdf

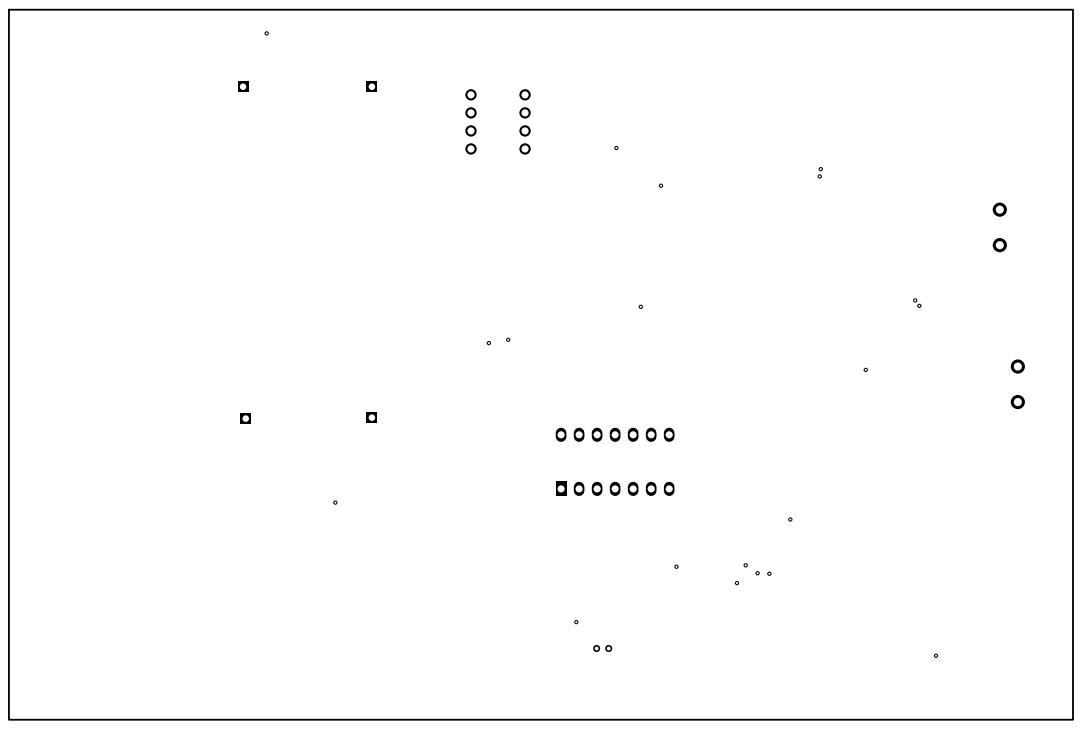
[picture p77: page 1]
