BrayanACelisGodoy/ProyectoUcurrentUIS/3.PCB_EasyEDA/BlancoYNegro/TopLayer.pdf

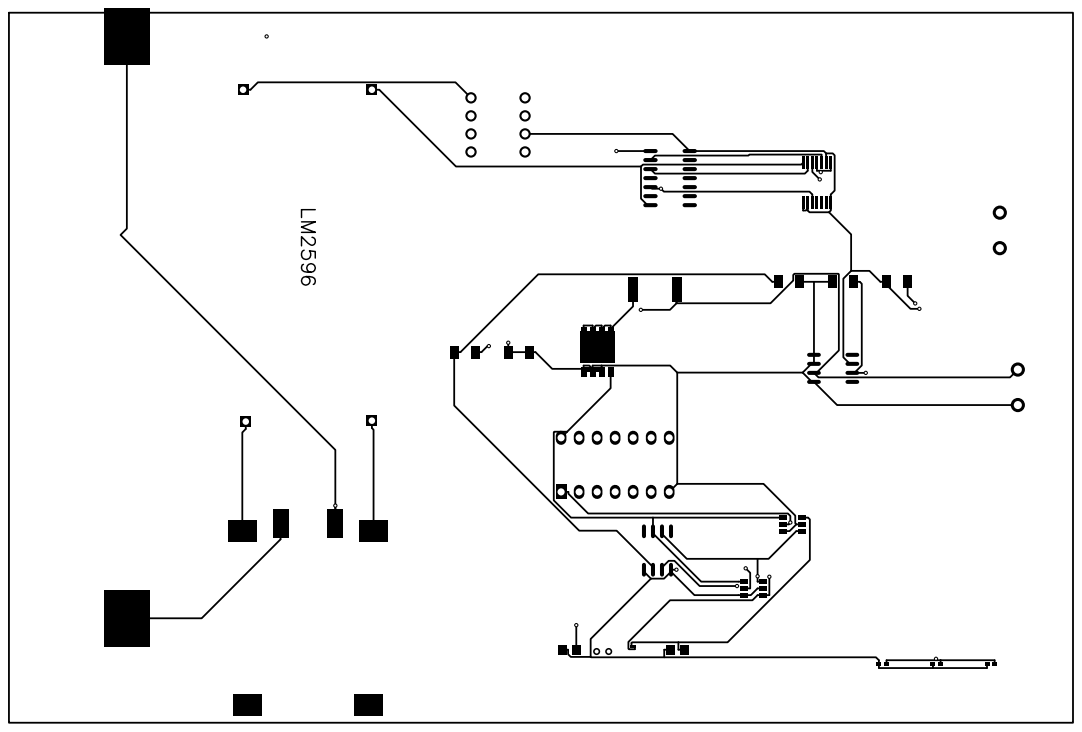
[picture p78: page 1]
