BrayanACelisGodoy/ProyectoUcurrentUIS/3.PCB_EasyEDA/BlancoYNegro/TopSilkLayer.pdf

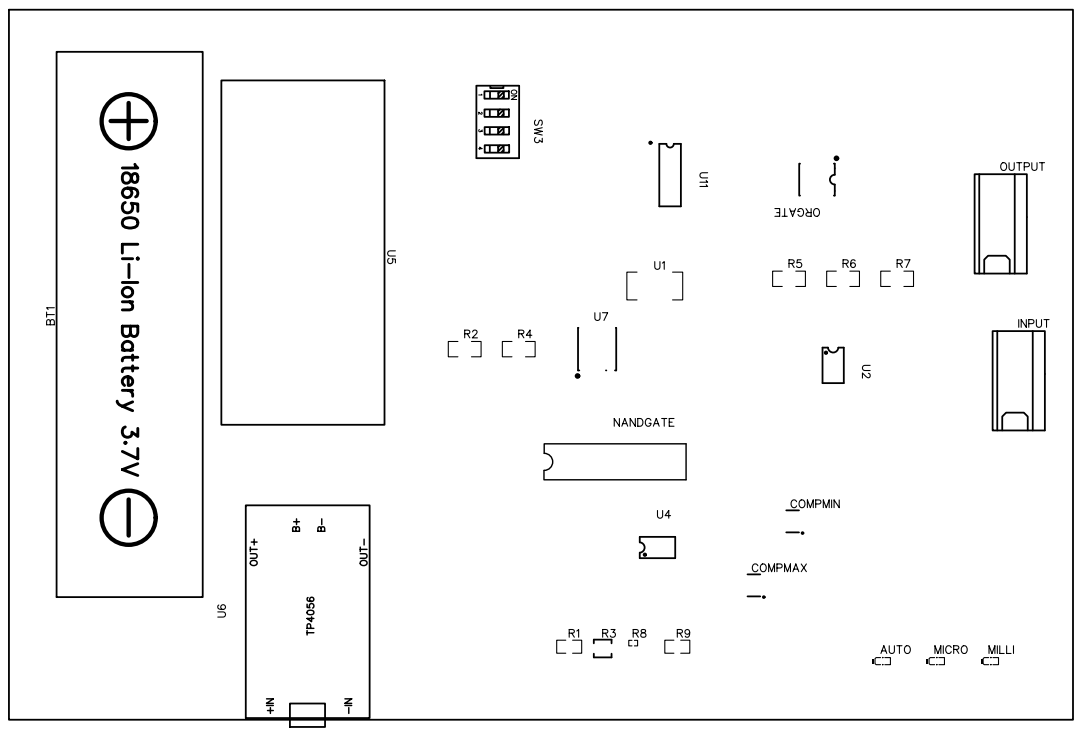
[picture p79: page 1]
