BrayanACelisGodoy/ProyectoUcurrentUIS/3.PCB_EasyEDA/FullColor/BottomLayer.pdf

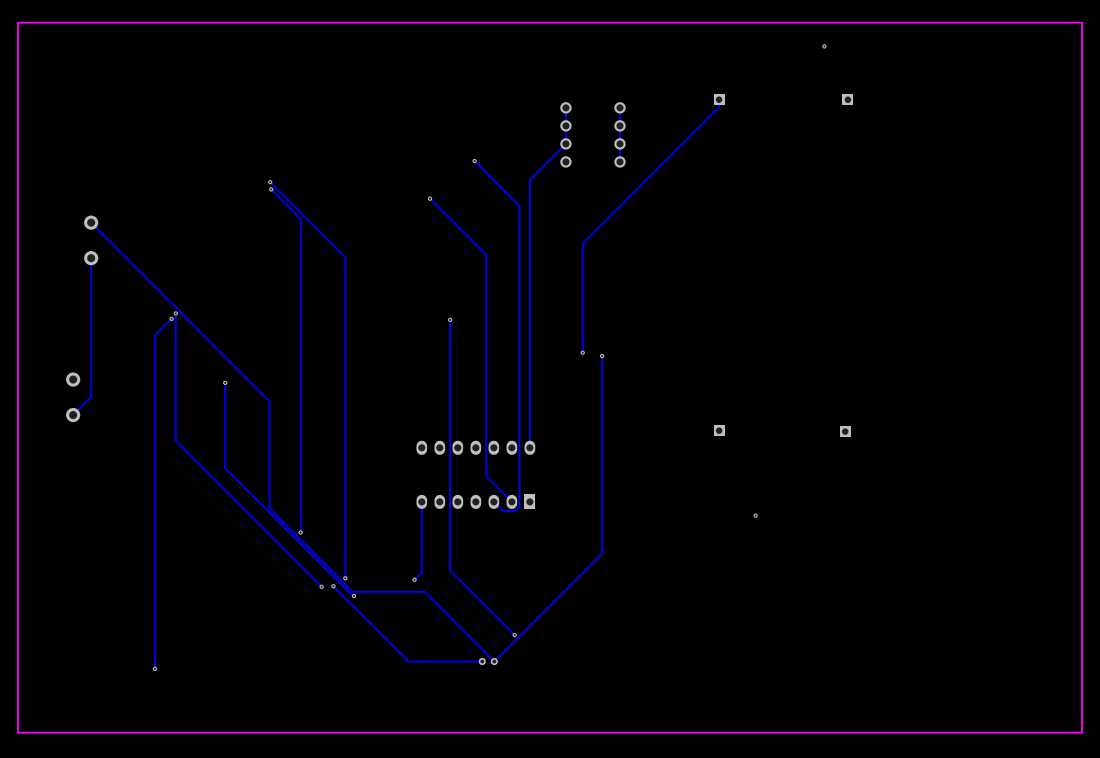
[picture p80: page 1]
