BrayanACelisGodoy/ProyectoUcurrentUIS/3.PCB_EasyEDA/FullColor/Multi-Layer.pdf

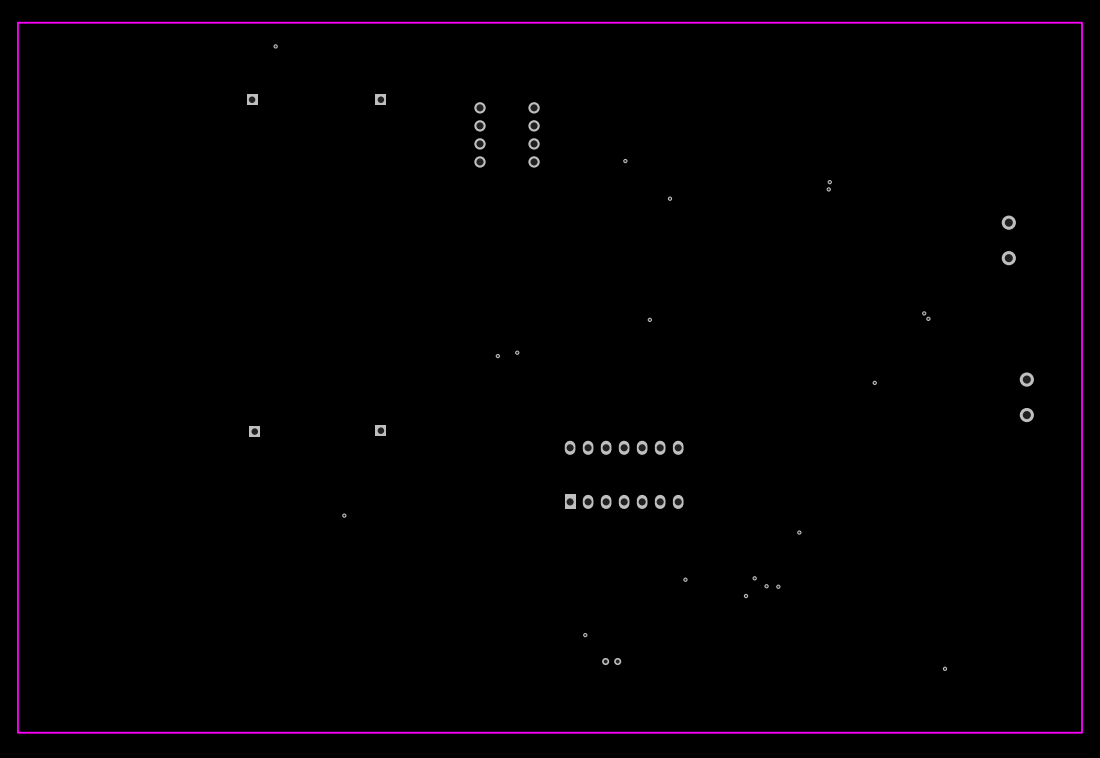
[picture p81: page 1]
