BrayanACelisGodoy/ProyectoUcurrentUIS/3.PCB_EasyEDA/FullColor/TopLayer.pdf

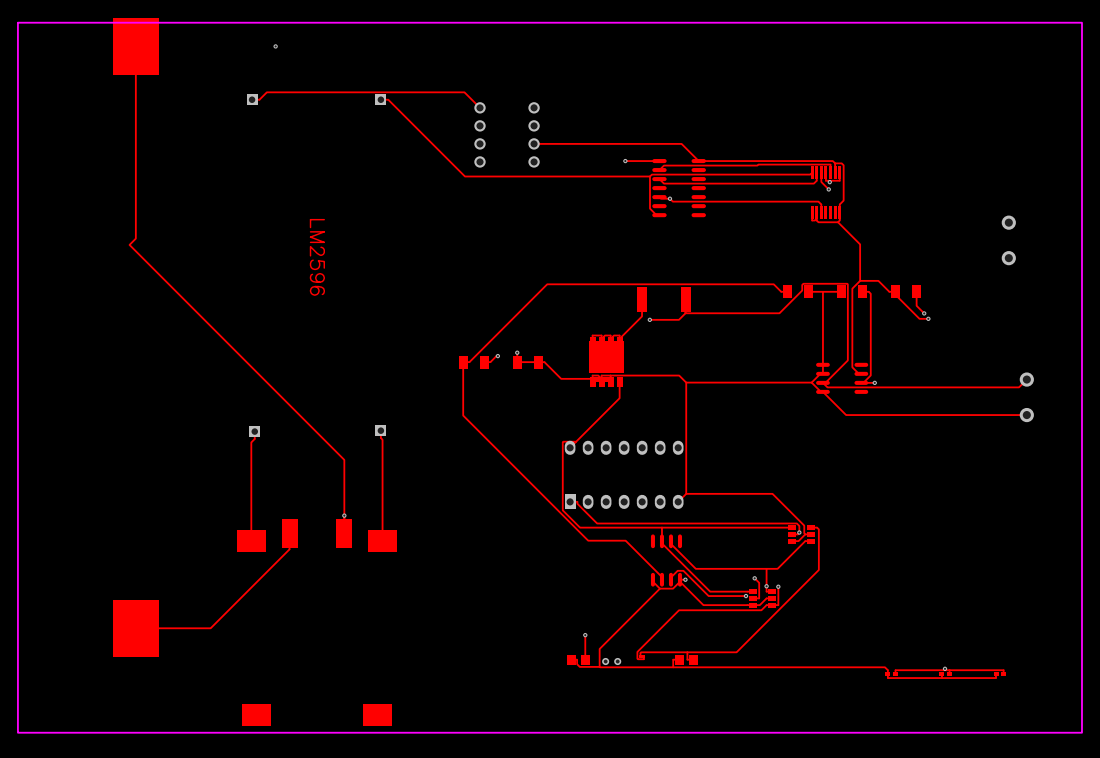
[picture p82: page 1]
