BrayanACelisGodoy/ProyectoUcurrentUIS/3.PCB_EasyEDA/FullColor/TopSilkLayer.pdf

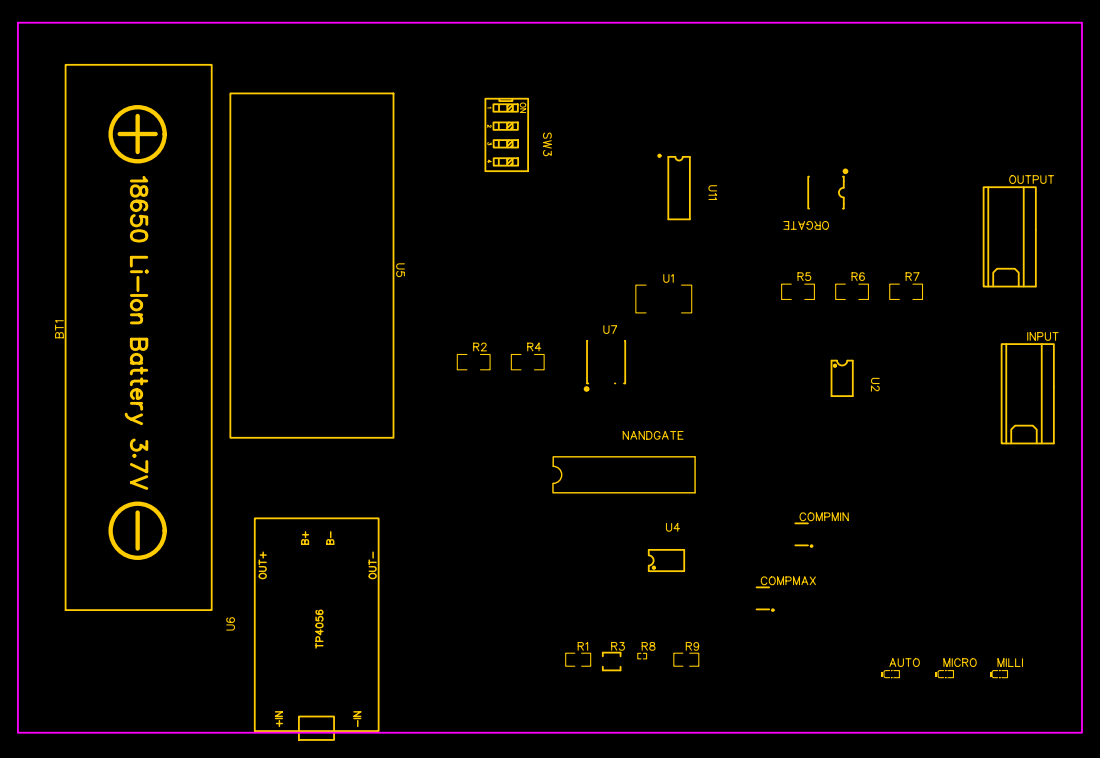
[picture p83: page 1]
