BrayanACelisGodoy/ProyectoUcurrentUIS/1.Simulaciones_LTSPICE/3.Esquematico_Medidor_Corriente_Completo/EsquematicoCompleto.pdf

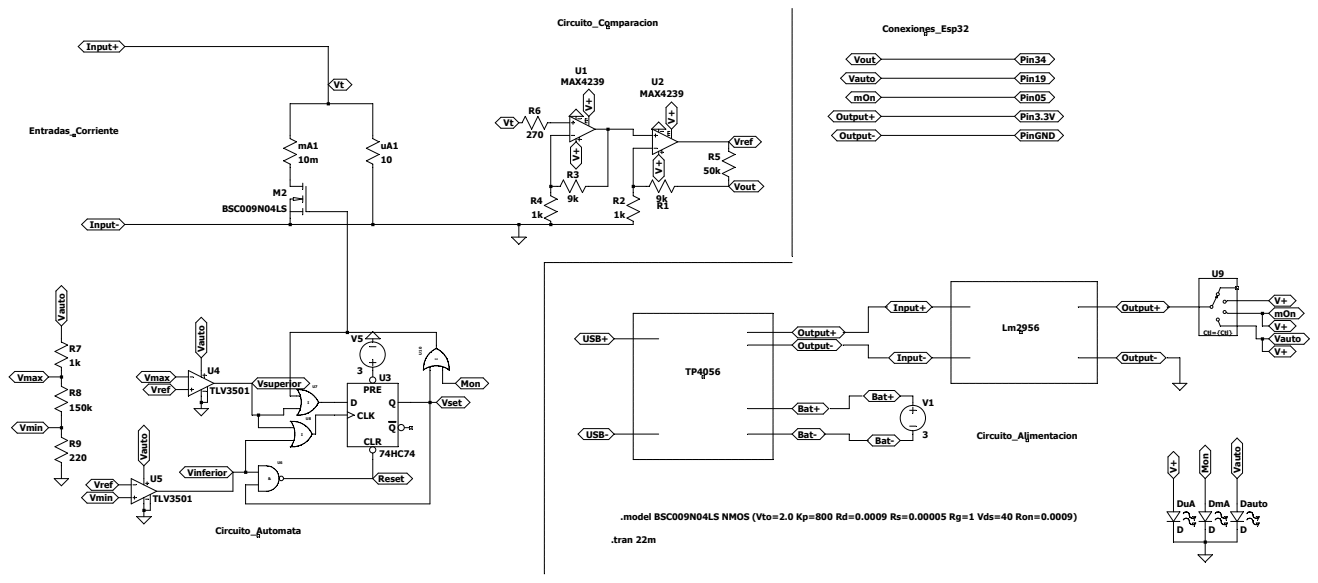
[picture p84: page 1]

.model BSC009N04LS NMOS (Vto=2.0 Kp=800 Rd=0.0009 Rs=0.00005 Rg=1 Vds=40 Ron=0.0009)
