BrayanACelisGodoy/ProyectoUcurrentUIS/1.Simulaciones_LTSPICE/2.Esquematico_Simulacion_Medidodr_Automatico/SistemaComparador.asc

FuenteCorriente_mA: current; PULSE(0 500m 10m 10m 1n 0 20m)
FunteCorriente_uA: current; PULSE(0 500u 0 10m 1n 0 20m)
M1: nmos; BSC009N04LS
mA: res; 10m
R1: res; 9k
R2: res; 1k
R3: res; 9k
R4: res; 1k
R5: res; 50k
R6: res; 270
U1: MAX4239
U2: MAX4239
U3: TLV3501
U4: TLV3501
U5: 74hc74; VCC=3  SPEED=1.0  TRIPDT=1e-9
U6: OR_2
U7: NAND_2
U8: OR_2
uA: res; 10
V1: voltage; 3
V2: voltage; 3
V3: voltage; 3
V5: voltage; 2.99
V6: voltage; 2.994m
Named nets: 0, V+, Vout, V-, Vt, Vref, Vset, Vsuperior, Vinferior, Reset
.model BSC009N04LS NMOS (Vto=2.0 Kp=800 Rd=0.0009 Rs=0.00005 Rg=1 Vds=40 Ron=0.0009)
.tran 22m
