BrayanACelisGodoy/ProyectoUcurrentUIS/1.Simulaciones_LTSPICE/3.Esquematico_Medidor_Corriente_Completo/EsquematicoCompleto.asc

Dauto: LED
DmA: LED
DuA: LED
M2: nmos; BSC009N04LS
mA1: res; 10m
R1: res; 9k
R2: res; 1k
R3: res; 9k
R4: res; 1k
R5: res; 50k
R6: res; 270
R7: res; 1k
R8: res; 150k
R9: res; 220
U1: MAX4239
U2: MAX4239
U3: 74hc74; VCC=3  SPEED=1.0  TRIPDT=1e-9
U4: TLV3501
U5: TLV3501
U6: NAND_2
U7: OR_2
U8: OR_2
U9: SP4T
U10: OR_2
uA1: res; 10
V1: voltage; 3
V5: voltage; 3
Named nets: 0, V+, Vout, Vt, Vref, Vset, Vsuperior, Vinferior, Reset, Vauto, Mon, mOn, Vmax, Vmin, Input+, Input-, TP4056, USB+, USB-, Bat+, Bat-, Output+, Output-, Lm2956, Circuito_Alimentacion, Circuito_Comparacion, Circuito_Automata, Entradas_Corriente, Pin34, Pin19, Pin05, Pin3.3V, PinGND, Conexiones_Esp32
.tran 22m
.model BSC009N04LS NMOS (Vto=2.0 Kp=800 Rd=0.0009 Rs=0.00005 Rg=1 Vds=40 Ron=0.0009)
