BrayanACelisGodoy/ProyectoUcurrentUIS/1.Simulaciones_LTSPICE/1.Esquematico_Simulacion_Medidor_Corriente_Ideal/CorrienteIdeal.asc

Iin: current; 500µ
R1: res; 9k
R2: res; 1k
R3: res; 9k
R4: res; 1k
R5: res; 50k
R9: res; 270
RuA: res; 10
U1: MAX4239
U2: MAX4239
V1: voltage; 3
V2: voltage; 3
Named nets: 0, V+, V-, Vout, Vburden, Vset
.op
