BrayanACelisGodoy/ProyectoUcurrentUIS/ProyectoLTSPICE/SimulacionMedicionCorriente/Draft3.asc

I1: current; 450µ
R1: res; 9k
R2: res; 1k
R3: res; 9k
R4: res; 1k
R5: res; 50k
R7: res; 10k
R9: res; 270
RmA: res; 10m
RuA: res; 10
U1: MAX4239
U2: MAX4239
U3: irlz44n
V1: voltage; 3
V2: voltage; 3
Named nets: 0, V+, V-, Vout
.op 10m
