BrayanACelisGodoy/ProyectoUcurrentUIS/(list of files, drawings)

Other design files:
3.PCB_EasyEDA/PCB_PCB_uCurrent_2_2024-10-28.json
3.PCB_EasyEDA/SCH_uCurrent_2024-10-28.json
