BrayanACelisGodoy/ProyectoUcurrentUIS/(commit log)

2024-09-27 Revert "Initial commit"
    This reverts commit 5c0491f74e25ec2df326ee752bc3347a00638a32.
    [Proyecto.pdsprj, ProyectoUcurrent.kicad_pcb, ProyectoUcurrent.kicad_sch]
2024-09-27 Reapply "Initial commit"
    This reverts commit 0fd2651cf4dfcaedd1c5525abca7450c85220472.
    [Proyecto.pdsprj, ProyectoUcurrent.kicad_pcb, ProyectoUcurrent.kicad_sch]
2024-09-27 Brayan
    Añadida de la simulacion del sistema medior de corriente
2024-09-27 DiseñoComparador
    Circuito de comparacion agregado para pruebas
2024-09-27 CambiosComparador
    Cambios En el sistema de comparacion con el lm358 en umbrales bajos funcional para que den la salida
2024-09-27 creacion documento de texto
2024-09-27 SeleccionMosfetConmutacion
    Se comprobo la simulacion del irlz44n que funciona para la conmutacion necesaria
2024-09-27 Cambios_al_Mosfet_Conmutador_Circuito
    se agrego el mosfet de conmutacion al circuito completo se espera simulacion en proteus
2024-09-27 IniciosCreacionCargadorBateria
    Se empieza a crear las pruebas de cargador pero no funciona
2024-09-27 CreacionProyectoEnProteus
    Se crea la simulacion inicial del proyecto en proteus para simulacion completa
    [ProyectoDiseñoUcurrent [20240927, 10-23-26].pdsprj, ProyectoDiseñoUcurrent.pdsprj]
2024-09-27 Proteus Cambios2
    [ProyectoDiseñoUcurrent [20240927, 10-58-00].pdsprj, ProyectoDiseñoUcurrent.pdsprj]
2024-09-30 Simulaciones Probadas en orcad
    Se intento simular en orcad pero sin provehco
    [ProyectoUcurrent.dsn, ProyectoUcurrent.opj, max4239.olb]
2024-10-01 se añadio una copia para pruebas ideales
2024-10-03 Cambios
    Cambios en no idealidad y en el comparador
2024-10-08 Cambios_Modelo_Mosfet
    Se cambio el modelo del mosfet al BSC009N04LS y se introdujo otra fuente de corriente para ver ambas funcionando en micro y milis
2024-10-08 Cambios Requeridos de carpetas
2024-10-09 Organizacion
    Se añadio y organizo las carpetas,y se creo el programa de la esp32 para la web
    [Proyecto.pdsprj, ProyectoDiseñoUcurrent [20240927, 10-23-26].pdsprj, ProyectoDiseñoUcurrent [20240927, 10-58-00].pdsprj, ProyectoDiseñoUcurrent.pdsprj, ProyectoUcurrent.dsn, ProyectoUcurrent.kicad_pcb, ProyectoUcurrent.kicad_sch, ProyectoUcurrent.opj]
2024-10-09 Elementos Innecesarios Borrados
    [max4239.olb]
2024-10-09 AjustesCarpetas
    AjustesCarpetas
    [ProyectoUcurrent.kicad_pcb, ProyectoUcurrent.kicad_sch]
2024-10-10 V2_Programa_Esp
    Se realizo una version dos de la aplicacion web en la cual se toma el saber la medicion mediante pines de la placa y no lo controla el rango la esp32s
2024-10-10 updates
    Ltspice tiene el switch 4 puertos,se creo y empezo a desarrollar el informe y
2024-10-10 AjustesCarpetas
    Se borraron carpetas ltspice innecesarias y se hizo el esquematico completo en ltspice
2024-10-10 añadida las librerias de ltspice
2024-10-10 Update_Informe_Progrma_app
    Programa aplicacion de celular
2024-10-15 AñadidoPCb
    [ProyectoUcurrent.kicad_pcb, ProyectoUcurrent.kicad_sch]
2024-10-31 Carpeta de imagenes
2024-11-21 update Final?
    [BOM_uCurrent_2024-10-15.csv]
